Marni3/CPReady/CODING-ESP32/6de3f12e1b0fb9c9b2b78985ee3d019f.jpeg

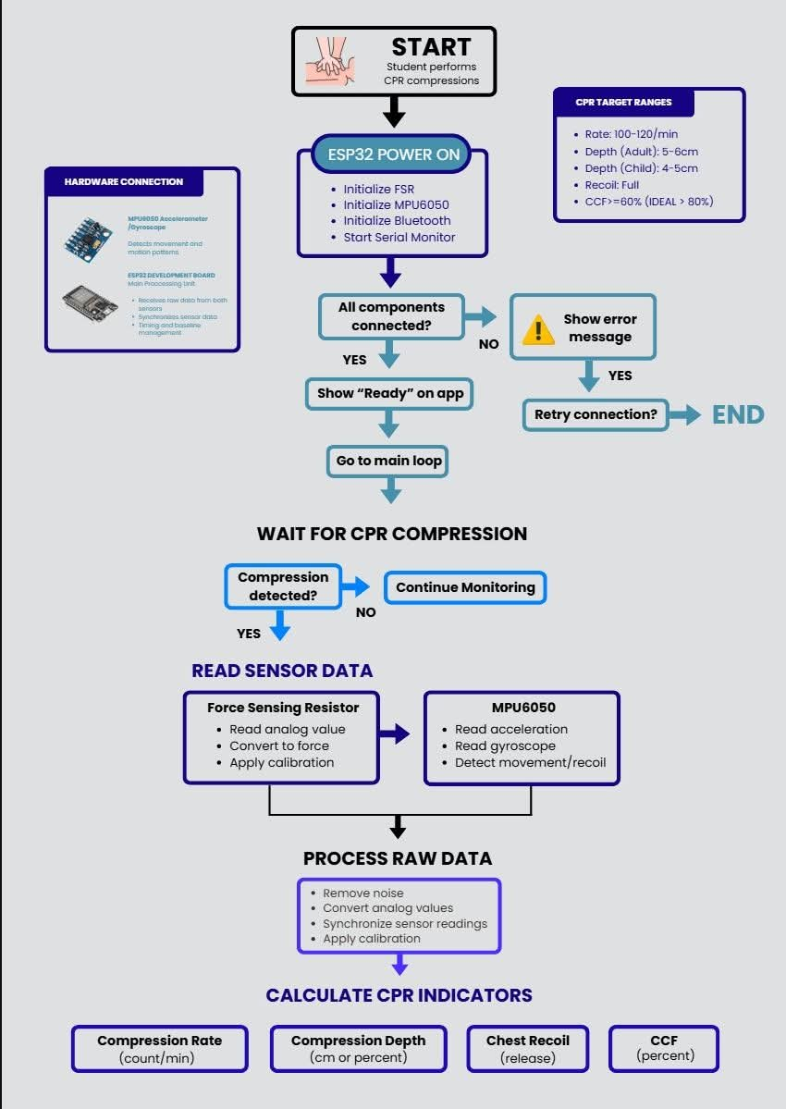
CODING-ESP32/6de3f12e1b0fb9c9b2b78985ee3d019f.jpeg
