Marni3/CPReady/FLUTTER/cpready/README.md

# CPReady Flutter Application

Flutter-based codebase for the **CPReady** CPR Training Vest prototype.

---

Android apk build
``` bash
flutter build apk --release
```
