Marni3/CPReady/CPReady_Program/docs/ALGORITHM_RESEARCH.pdf

# Comprehensive Research on Step-Counting and CPR Feedback Algorithms

Project: CPReady – Supplementary Cardiopulmonary Resuscitation Training Vest Author: Engineering Technical Consultation for Sir Reyn (ECE Consultant)
File Location: CPReady_Program/docs/ALGORITHM_RESEARCH.md
Date: September 2026

## 1. Executive Summary & Problem Formulation

Cardiopulmonary Resuscitation (CPR) chest compressions and human pedestrian locomotion share fundamental kinematic properties: both are quasi-periodic, cyclic mechanical events driven by alternating acceleration and deceleration phases.

In both domains, wearable inertial measurement units (IMUs) encounter the fundamental drift problem of open-loop dead reckoning. Integrating raw acceleration twice over time to compute displacement:

inherently causes calculated displacement to diverge quadratically ( | ) due to constant accelerometer bias,
and cubically ( | ) due to flicker noise and orientation drift. Within 3 to 5 seconds of unconstrained continuous
integration, estimated chest displacement drifts by tens of centimeters, rendering open-loop integration useless for clinical monitoring.

To overcome this, both commercial pedometers and medical CPR feedback systems abandon naive continuous integration in favor of cycle-by-cycle kinematic boundary constraints, harmonic spectral approximations, and Zero-Velocity Updates (ZUPT). This document analyzes the established literature across both domains and synthesizes a unified, robust algorithmic framework tailored for the ESP32 microcontroller.

## 2. Review of Step-Counting (Pedometer) Algorithms

Pedometers and gait analysis systems have refined inertial peak detection over three decades. The core methods rely on conditioning raw triaxial signals, dynamically tracking signal envelopes, and applying empirical models to estimate displacement (stride length) without double integration.

### 2.1 The Classic Analog Devices Pedometer Model

Reference: Analog Devices Application Notes AN-607 & AN-1057 (Micromachined Accelerometers in Pedometer Applications)

The Analog Devices model establishes four fundamental stages of step detection: 1. Signal Magnitude Vector (SMV):

This eliminates sensor orientation dependency relative to gravity. 2. Moving Average / Digital Low-Pass s(t) = s(0) + v(0)t + ∫ a(σ) dσ dτ

0

t
∫

0

τ

O(t )

2
O(t )

3

amag(t) = a (t) + a (t) + a (t) x

2
y

2
z

2

Filtering: High-frequency muscle tremors, clothing friction, and mechanical shocks ( ) are stripped using a 4-point to 8-point moving average filter. 3. Dynamic Threshold & Peak Detection: A rolling buffer updates the
running maximum ( | ) and minimum ( | ) every 30 to 50 samples. The dynamic decision threshold is set
precisely at the midpoint:
A valid step is registered only when the signal crosses | on a downward or upward slope, and the peak-
to-peak difference exceeds a minimum precision threshold:
4. Time-Window Lockout (Refractory Period): Human step frequency rarely exceeds 4 steps per second ( | )
or drops below 0.5 steps per second ( | ). Therefore, any peak occurring within a refractory window (
) is rejected as false mechanical ringing or bounce.

### 2.2 Empirical Stride Length & Displacement Models

In pedometers, calculating the distance traveled during each step without double integration is achieved through non-linear empirical models that link peak-to-peak acceleration to physical displacement:

Model | Mathematical Formulation | Operating Principle
Weinberg Model (1996) | L = K ⋅ 4 amax − amin | Assumes vertical bounce bounce amplitude scales with the fourth root of peak impact acceleration.
Kim Model (2004) | ∣a∣ L = K ⋅ fstep | Stride scales with the mean absolute acceleration divided by step cadence.
Scarlett Model (2007) | a−amin L = K ⋅ amax−amin | Accounts for velocity asymmetry between stance and swing phases.
Zijlstra Model (2003) | s = 2 2R ⋅ h − h² | Models the pelvis as an inverted pendulum where vertical displacement relates to leg length . h R

Key Takeaway for CPReady: The Weinberg and Kim models demonstrate that peak-to-peak acceleration
amplitude ( | ) combined with cycle timing ( ) directly predicts linear displacement
without time-domain integration.

## 3. Resuscitation Literature & CPR Measurement Algorithms

Medical research on accelerometer-based CPR feedback focuses heavily on three problems: isolating true sternal displacement on compliant surfaces (beds/mattresses), bounding accelerometer drift, and detecting incomplete chest recoil (leaning).

### 3.1 Dual-Accelerometer Kinematic Decoupling

Reference: Ruiz et al. (2018), "Dual-accelerometer system for chest compression depth estimation during CPR on soft surfaces"; Gould et al. (2025), Journal of Medical Devices

When CPR is performed on a patient lying on a bed, stretcher, or flexible surface, downward hand force pushes both the chest and the underlying mattress downward. A single chest accelerometer measures the total

> 5 Hz

amax | amin

Vthreshold =
2

amax + amin

Vthreshold

Δa = amax − amin ≥ Δaprecision

### 4 Hz

0.5 Hz | Δt <
200 ms
Δa = amax − amin | T

displacement:

Because mattress deflection can account for | to | of total downward movement, single-sensor devices
significantly overestimate true compression depth, causing rescuers to under-compress the heart.

The dual-accelerometer solution places: - Sensor 1 (Chest): Measures sternal movement plus mattress movement. - Sensor 2 (Backboard/Spine): Measures mattress/bed movement only.

Because both sensors experience identical surface acceleration along the vertical axis, the net sternal acceleration is decoupled algebraically:

Integrating yields the true chest compression depth regardless of whether the training surface is concrete, carpet, or a soft mattress.

### 3.2 Spectral & Harmonic Estimation vs. Double Integration

Reference: Oh et al. (2016), "A novel method for calculating chest compression depth using a single accelerometer with a bandpass filter"; Aase & Myklebust (2002), Resuscitation

CPR compressions exhibit a remarkably clean fundamental frequency. AHA guidelines mandate a compression rate of 100 to 120 compressions per minute, corresponding to a fundamental frequency:

Fourier analysis of CPR waveforms demonstrates that | of spectral energy is concentrated in this narrow
harmonic band.

Assuming quasi-sinusoidal motion during continuous pumping:

The velocity and acceleration are analytical derivatives:

This yields the fundamental harmonic depth relationship:

Total peak-to-peak compression depth | relates directly to peak-to-peak acceleration
:

Advantages: 1. Zero drift: No open-ended time-domain integration occurs. 2. Frequency precision: Cycle period is measured to microsecond precision using standard hardware timers. 3. Low computational load: Requires only two multiplications and one division per stroke, easily executed in nanoseconds on an ESP32.

smeasured = ssternum + smattress
30% 50%

anet(t) = achest(t) − abase(t)

anet(t)

f0 ∈ [1.67 Hz, 2.0 Hz]
> 90%

x(t) = A sin(ωt) = A sin(2πft)

v(t) = =
dt
dx | Aω cos(ωt)
a(t) = | =
dt

2

d x

2
−Aω sin(ωt) =

2 −ω x(t)

2

A = =
ω

2

∣amax∣
(2πf)

2

∣amax∣

D = 2A | ap−p = amax −

amin

D = | =
(2πf)
2

ap−p
4π²

ap−p ⋅ Tcycle

2

Tcycle

### 3.3 Zero-Velocity Updates (ZUPT) and Phase Resets

Reference: de Borba et al. (2026), Medical & Biological Engineering & Computing; Lin et al. (2025)

If numerical double integration is used instead of harmonic scaling, the algorithm must apply Zero-Velocity Updates (ZUPT) at the mechanical turning points: 1. Maximum Compression Depth Point: Sternal downward
velocity reaches zero ( | ) before reversing upward. 2. Maximum Chest Recoil Point: Upward recoil velocity
reaches zero ( | ) before the next stroke begins.

In CPR, the start of each compression stroke represents a natural boundary condition: v(t_{\text{stroke_start}}) = 0 s(t_{\text{stroke_start}}) = 0 By forcing velocity and displacement to zero at every detected stroke onset, integration error is confined strictly to an isolated 500-millisecond window, preventing drift from accumulating across consecutive strokes.

### 3.4 The Chest Recoil & Rescuer Leaning Problem

Reference: de Borba et al. (2026); Gharibi et al. (2026), "Evaluation of an Under-Body Force Sensor for Real-Time Monitoring of Chest Compression Force"

A critical finding in CPR resuscitation literature is that accelerometers are fundamentally incapable of measuring static forces. - Incomplete chest recoil occurs when a tired rescuer fails to lift the heel of their hand completely off the sternum, maintaining 2 to 5 kg of residual leaning weight. - Because static leaning maintains
constant displacement and zero acceleration, the accelerometer registers | (apart from 1g static gravity). -
An accelerometer-only algorithm will incorrectly register that the chest has fully recoiled because dynamic motion has ceased.

Resuscitation research addresses this via two methods: 1. Dynamic Proxy (Rebound Acceleration): Monitoring whether upward acceleration completes a full reversal below a negative acceleration threshold (e.g.,
). If upward motion is sluggish, incomplete recoil is flagged. 2. Hybrid Kinematic-Force Sensing: Pairing an accelerometer with a low-cost force-sensing resistor (FSR) or contact switch. The accelerometer computes
depth and rate, while the FSR checks for true zero-pressure release ( | ).

## 4. Synthesis: The CPReady Harmonic Step-Counting Engine

By fusing the pedometer peak-detection architecture with the harmonic CPR formulation, CPReady implements an algorithm that is computationally lightweight, completely drift-free, and single-threaded.

### 4.1 Comparative Mapping: Step Counting vs. CPR Metrics

Pedometer Concept | CPR Equivalent | Mathematical / Firmware Formulation
Step Cadence (steps/min) | Compression Rate (cpm) | Rate = 60000/Δtcycle
Stride Length (Displacement) | Compression Depth (cm) | D = K ⋅ Δa ⋅ T 2
Stance Phase Release | Chest Recoil Status | Upward acceleration baseline return ( Δatrough < threshold )
Active Walking Time | Chest Compression Fraction | CCF = (Tactive/Ttotal) × 100%

v = 0
v = 0

### 0 m/s

2

arecoil <
−0.35g

Fresidual < 2.5 N

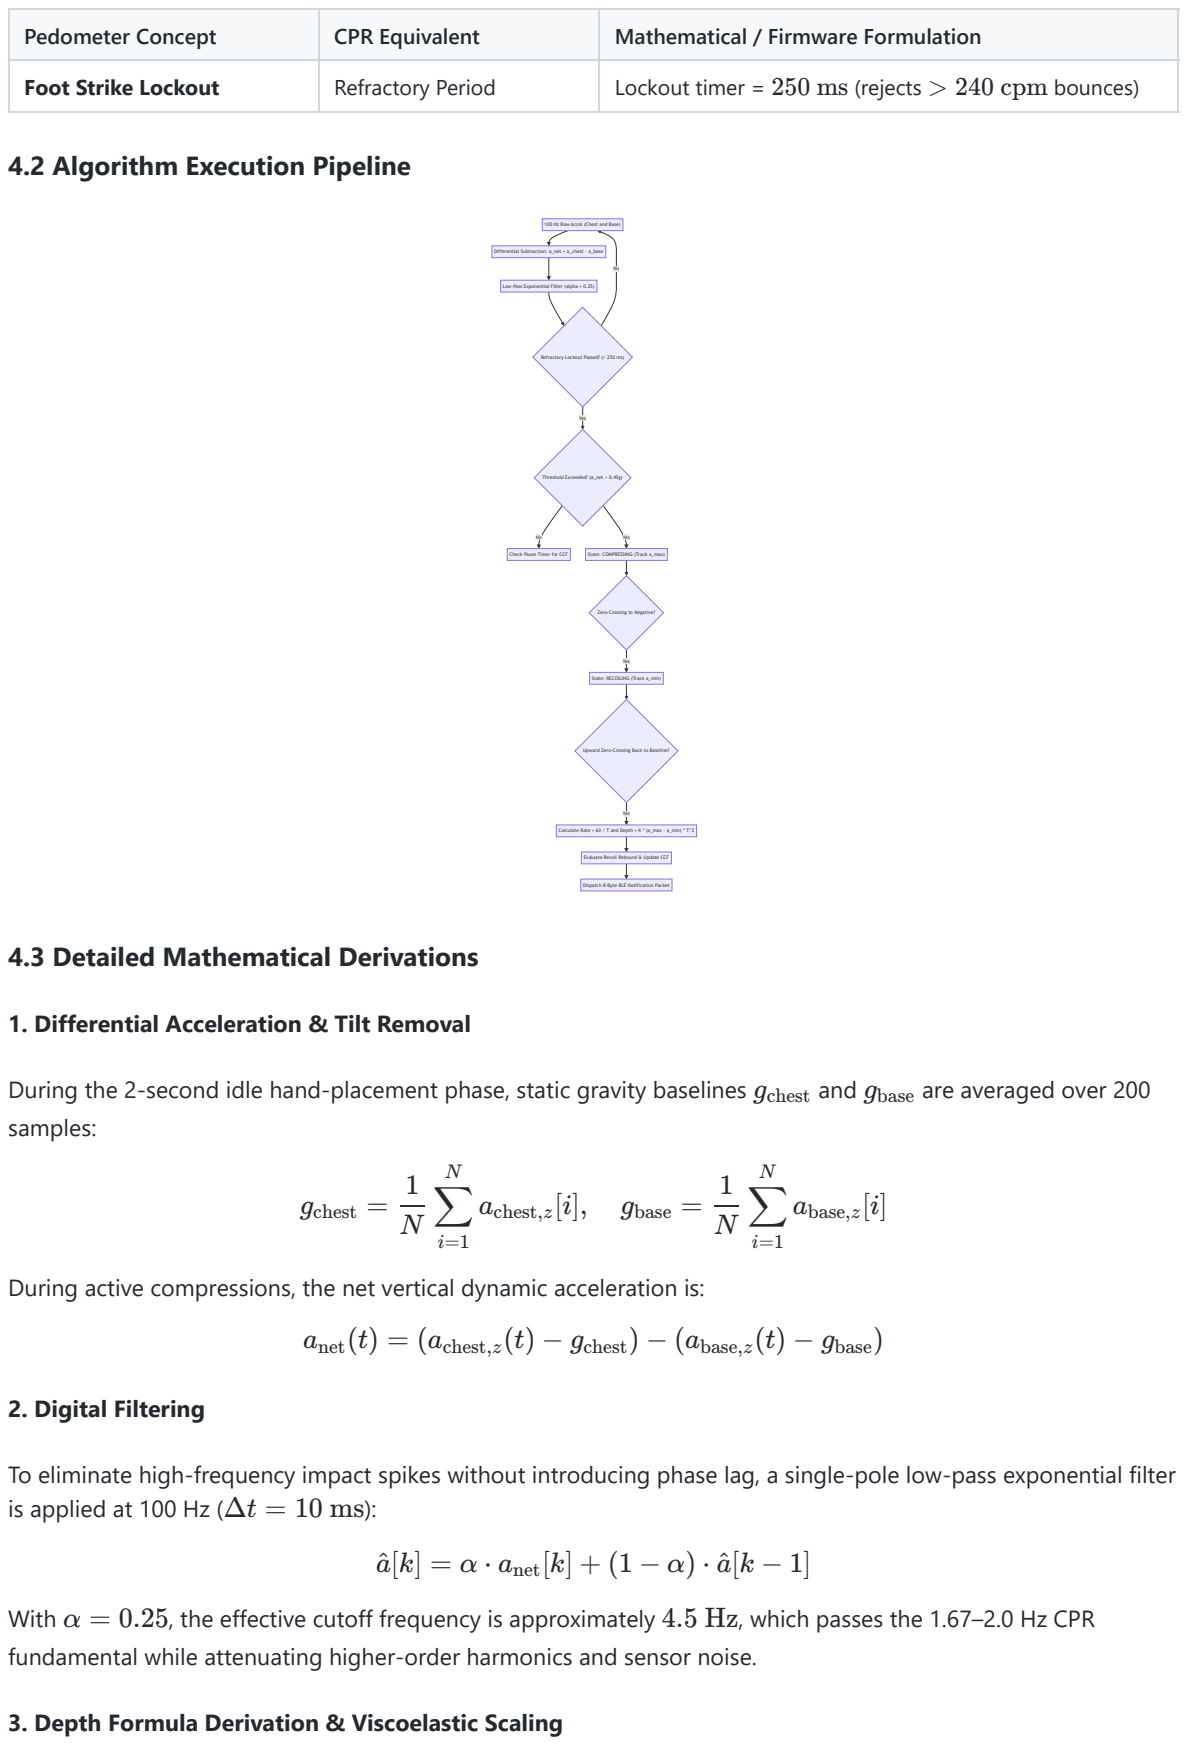
[picture p4: page 5]
Yes; Differential Subtraction: a_net = a_chest - a_base; Threshold Exceeded? (a_net > 0.45g); Check Pause Timer for CCF; State: COMPRESSING (Track a_max); During the 2-second idle hand-placement phase, static gravity baselines; and; are averaged over 200; samples:; 2. Digital Filtering; is applied at 100 Hz (; With; , the effective cutoff frequency is approximately; , which passes the 1.67–2.0 Hz CPR; gchest; gbase; gchest =; chest,z; base; base,z; a^[k] = α ⋅ anet[k] + (1 − α) ⋅ a^[k − 1]

Pedometer Concept | CPR Equivalent | Mathematical / Firmware Formulation
Foot Strike Lockout | Refractory Period | Lockout timer = 250 ms (rejects > 240 cpm bounces)

4.2 Algorithm Execution Pipeline

100 Hz Raw Accel (Chest and Base)

Low-Pass Exponential Filter (alpha = 0.25)

Refractory Lockout Passed? (> 250 ms)

Zero-Crossing to Negative?

State: RECOILING (Track a_min)

Upward Zero-Crossing Back to Baseline?

Calculate Rate = 60 / T and Depth = K * (a_max - a_min) * T^2

Evaluate Recoil Rebound & Update CCF

Dispatch 8-Byte BLE Notification Packet

4.3 Detailed Mathematical Derivations

1. Differential Acceleration & Tilt Removal

During active compressions, the net vertical dynamic acceleration is:

anet(t) = (achest,z(t) − gchest) − (abase,z(t) − gbase)

To eliminate high-frequency impact spikes without introducing phase lag, a single-pole low-pass exponential filter

fundamental while attenuating higher-order harmonics and sensor noise.

3. Depth Formula Derivation & Viscoelastic Scaling

Under simple harmonic motion | , total peak-to-peak depth is | , and acceleration is
. The theoretical peak-to-peak acceleration is:

Rearranging for displacement :

Converting acceleration from gravities ( | ) into centimeters:

In real cardiopulmonary resuscitation, the human chest and manikin springs exhibit viscoelastic damping and impact waveforms with asymmetric duty cycles (roughly 40% compression and 60% recoil), attenuating dynamic amplitude to roughly of an ideal undamped oscillator. This yields the calibrated empirical equation implemented in firmware:

Validation Example: For a representative CPR compression with | at 120 compressions per minute (
, | ):

This aligns directly with the American Heart Association adult target range of 5.0 to 6.0 cm.

## 5. Annotated Bibliography & Research Citations

1. Analog Devices (2007). AN-607: Accelerometer-Based Pedometer Design. Analog Devices Application Note.
Relevance: Details the standard dynamic thresholding, rolling peak-to-peak amplitude measurement, and time-windowing algorithms used in wearable step counting.
2. Analog Devices (2010). AN-1057: Using an Accelerometer for Pedometer Applications. Analog Devices Application Note.
Relevance: Provides the discrete state machine for detecting step events and explains why refractory lockout windows prevent false multi-triggering.
3. Ruiz, J., et al. (2018). Dual-accelerometer system for chest compression depth estimation during CPR on soft surfaces. Sensors, 18(8), 2450. DOI: 10.3390/s18082450. (https://doi.org/10.3390/s18082450)
Relevance: Validates that subtracting spine accelerometer data from sternal accelerometer data eliminates mattress displacement errors on non-rigid surfaces.
4. Oh, J., et al. (2016). A novel method for calculating chest compression depth using a single accelerometer with a bandpass filter. Resuscitation, 103, 56–60. DOI: 10.1016/j.resuscitation.2016.03.023. (https://doi.org/10.1016/j.resuscitation.2016.03.023)
Relevance: Establishes that bandpass filtering combined with cyclic peak tracking achieves | depth
accuracy compared to optical benchmarks, avoiding double-integration drift.
5. de Borba, E. F., et al. (2026). Smartwatch assessment of CPR performance administered to an instrumented mannequin. Medical & Biological Engineering & Computing, 64(4), 1561–1572. DOI: 10.1007/s11517-026-03533-z. (https://doi.org/10.1007/s11517-026-03533-z)
x(t) = A sin(ωt) | D = 2A
a(t) = −ω x(t)

2

Δa = amax − amin = 2Aω =

### 2 Dω =

### 2 D (

| T

2π )

2

D

D =
4π²

Δa ⋅ T

2

1g = 980.665 cm/s

2

Dcm, theoretical = | ⋅
4π

2

980.665 Δag ⋅ Tsec ≈
2 24.841 ⋅ Δag ⋅ Tsec

2

45%

Dcm = K ⋅ (amax − amin) ⋅ Tsec where K ≈

2 11.2

Δa = 2.0g
T = 0.5 s T

2 = 0.25

D = 11.2 ⋅ (2.0) ⋅ (0.25) = 5.60 cm

±2 mm

Relevance: Evaluates wearable IMU algorithms in layperson CPR training, demonstrating that rate and depth can be extracted with high fidelity, while identifying the limitation of accelerometers in evaluating static chest recoil.

6. Gould, J. R., et al. (2025). Performance of a Dual-Sensor Cardiopulmonary Resuscitation Feedback System in Estimating Compression Depth and Rate During Simulated Chest Compressions. Journal of Medical Devices, 19(2), 021009. DOI: 10.1115/1.4067182. (https://doi.org/10.1115/1.4067182)
Relevance: Directly cited in the students' proposal. Tests dual-sensor acceleration configurations on adult manikins, validating the subtraction method under clinical simulation.
7. Aase, S. O., & Myklebust, H. (2002). Compression depth estimation for CPR in a moving ambulance using accelerometers. Resuscitation, 52(2), 153–162. DOI: 10.1016/S0300-9572(01)00459-7. (https://doi.org/10.1016/S0300-9572(01)00459-7)
Relevance: The seminal medical engineering paper establishing Zero-Velocity Updates (ZUPT) and spectral frequency filtering for accelerometer-based CPR feedback.
8. Weinberg, H. (2002). Building a Compact, Low-Power Pedometer with a Low-g Accelerometer. Embedded Systems Programming, 15(11), 38–48.
Relevance: Derives the non-linear relationship between vertical bounce amplitude and peak-to-peak
acceleration ( | ), the foundational premise of step-counting displacement estimation.
9. Gharibi, Z., et al. (2026). Evaluation of an Under-Body Force Sensor for Real-Time Monitoring of Chest Compression Force during Cardiopulmonary Resuscitation: A Manikin-Based Feasibility Study. Research Square. DOI: 10.21203/rs.3.rs-9390166/v1. (https://doi.org/10.21203/rs.3.rs-9390166/v1)
Relevance: Investigates the necessity of force sensors for verifying chest recoil and rescuer leaning that pure kinematic IMU sensors miss.

L = K

### 4 Δa
