Marni3/CPReady/CODING-ESP32/0459f18023e26a456a915082fbb5177e.jpeg

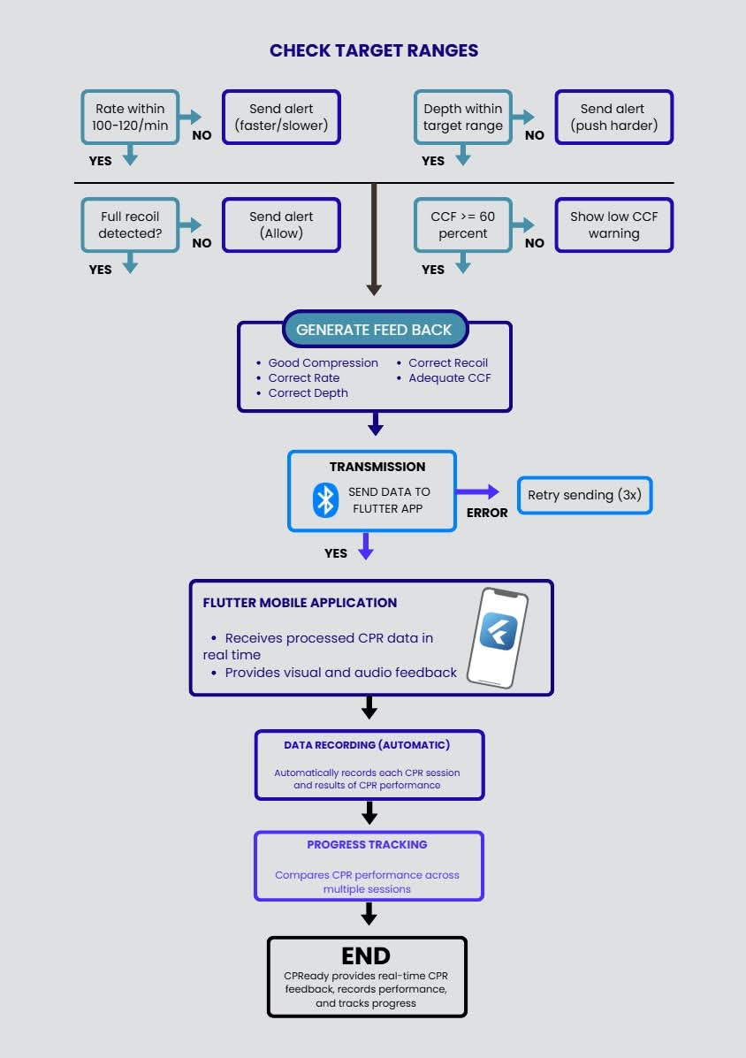
CODING-ESP32/0459f18023e26a456a915082fbb5177e.jpeg
