Marni3/CPReady/DATA/Double MPU/2MPU_Strict2.jpg

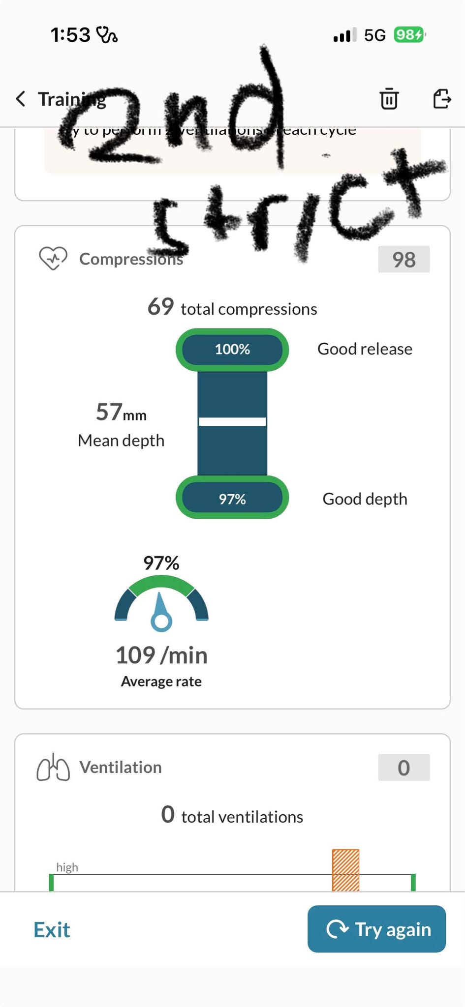
DATA/Double MPU/2MPU_Strict2.jpg
