Marni3/CPReady/DATA/organized_trials/01_2MPU_Balanced1_a4dc7413/2MPU_Balanced1.jpg

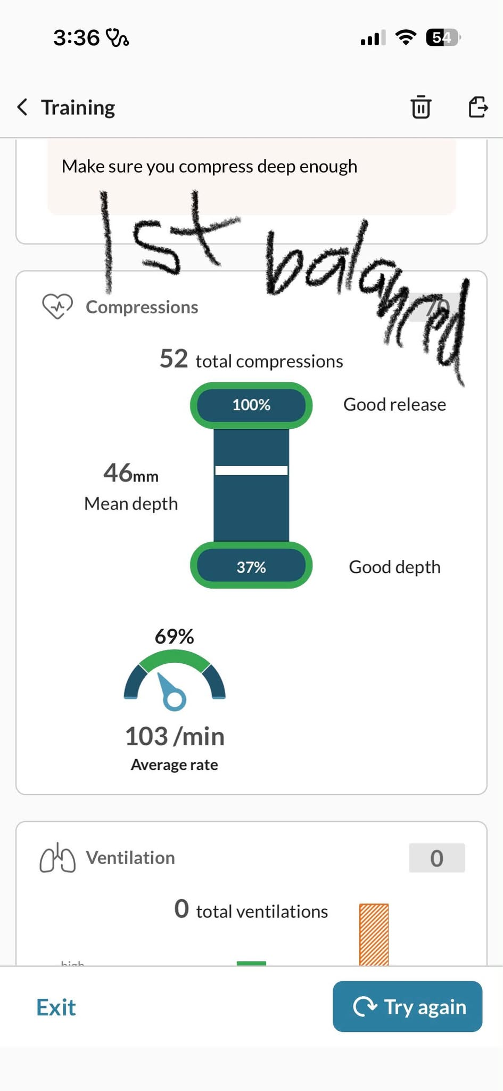
DATA/organized_trials/01_2MPU_Balanced1_a4dc7413/2MPU_Balanced1.jpg
