Marni3/CPReady/DATA/organized_trials/02_2MPU_Balanced2_e5e68774/2MPU_Balanced2.jpg

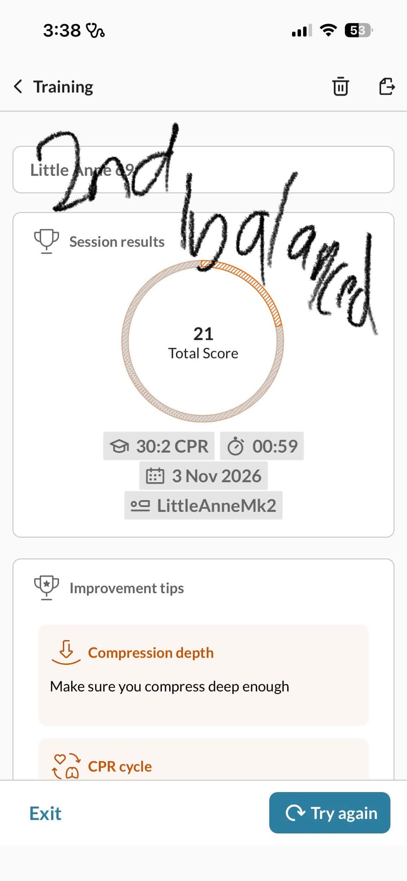
DATA/organized_trials/02_2MPU_Balanced2_e5e68774/2MPU_Balanced2.jpg
