Marni3/CPReady/DATA/organized_trials/04_2MPU_Strict1_7c5ea2c3/2MPU_Strict1.jpg

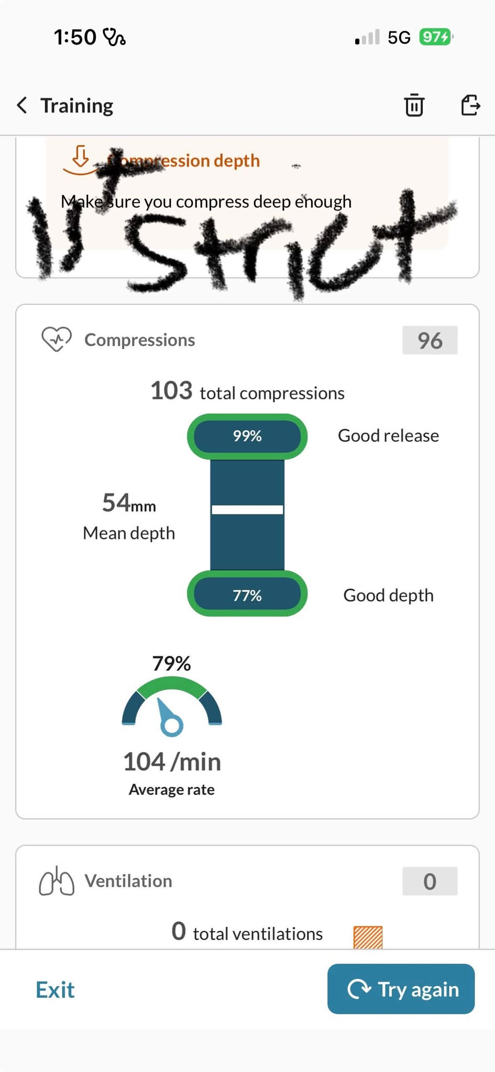
DATA/organized_trials/04_2MPU_Strict1_7c5ea2c3/2MPU_Strict1.jpg
