Marni3/CPReady/DATA/organized_trials/06_2MPU_High1_343540cf/2MPU_High1.jpg

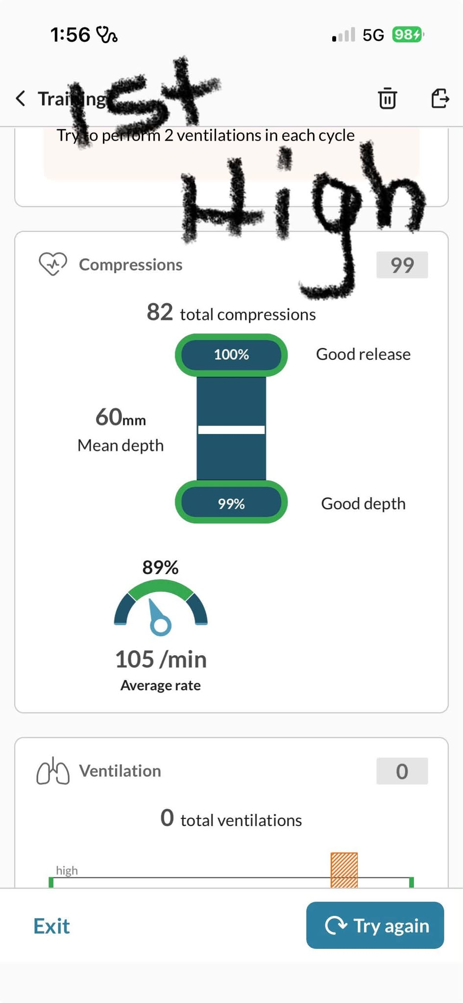
DATA/organized_trials/06_2MPU_High1_343540cf/2MPU_High1.jpg
