Marni3/CPReady/DATA/organized_trials/07_2MPU_High2_e5c4ad3a/2MPU_High2.jpg

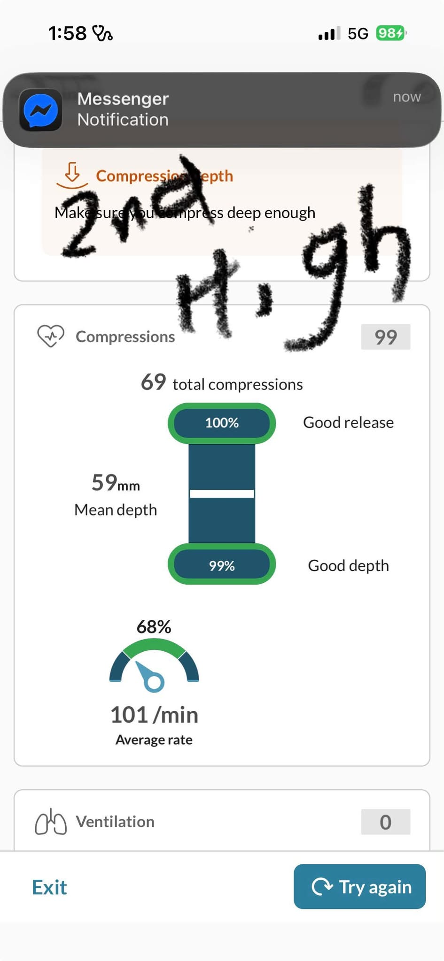
DATA/organized_trials/07_2MPU_High2_e5c4ad3a/2MPU_High2.jpg
