Marni3/CPReady/DATA/organized_trials/08_1MPU_Strict1_6ee8938f/1MPU_Strict1.jpg

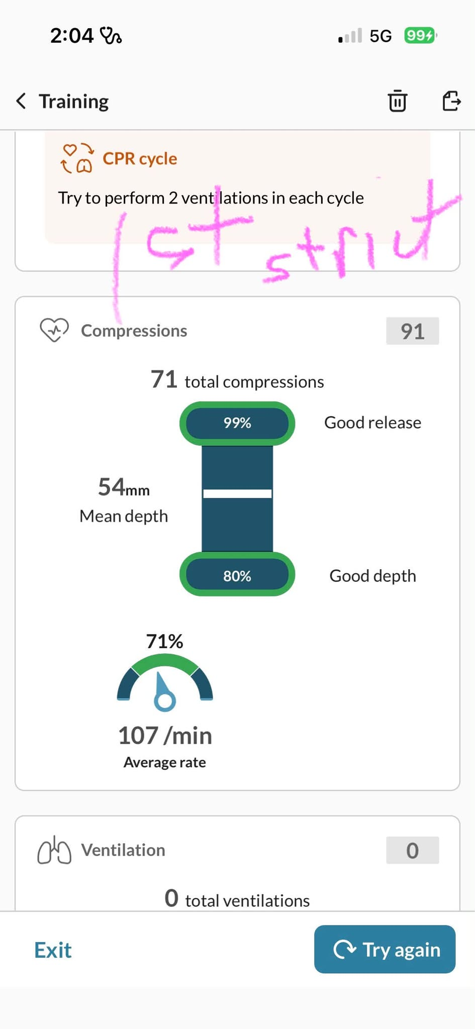
DATA/organized_trials/08_1MPU_Strict1_6ee8938f/1MPU_Strict1.jpg
