Marni3/CPReady/DATA/organized_trials/10_1MPU_Balanced1_48011a51/1MPU_Balanced1.jpg

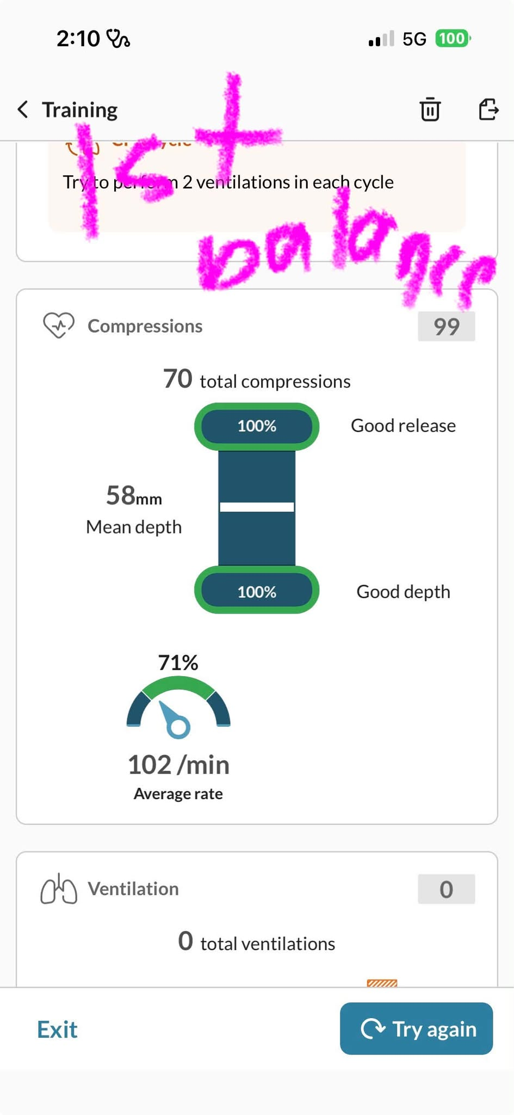
DATA/organized_trials/10_1MPU_Balanced1_48011a51/1MPU_Balanced1.jpg
