Marni3/CPReady/DATA/Single MPU/1MPU_Balanced2.jpg

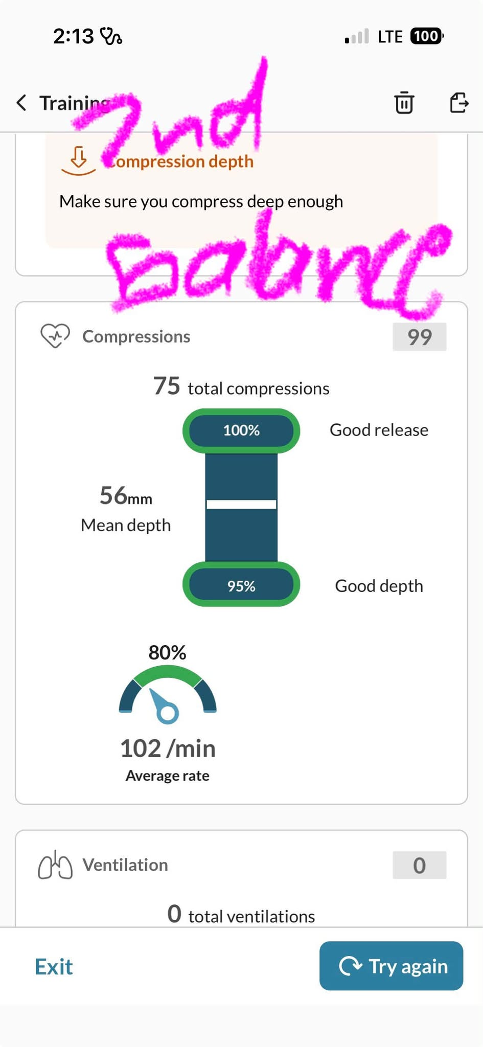
DATA/Single MPU/1MPU_Balanced2.jpg
