Marni3/CPReady/DATA/Single MPU/1MPU_High1.jpg

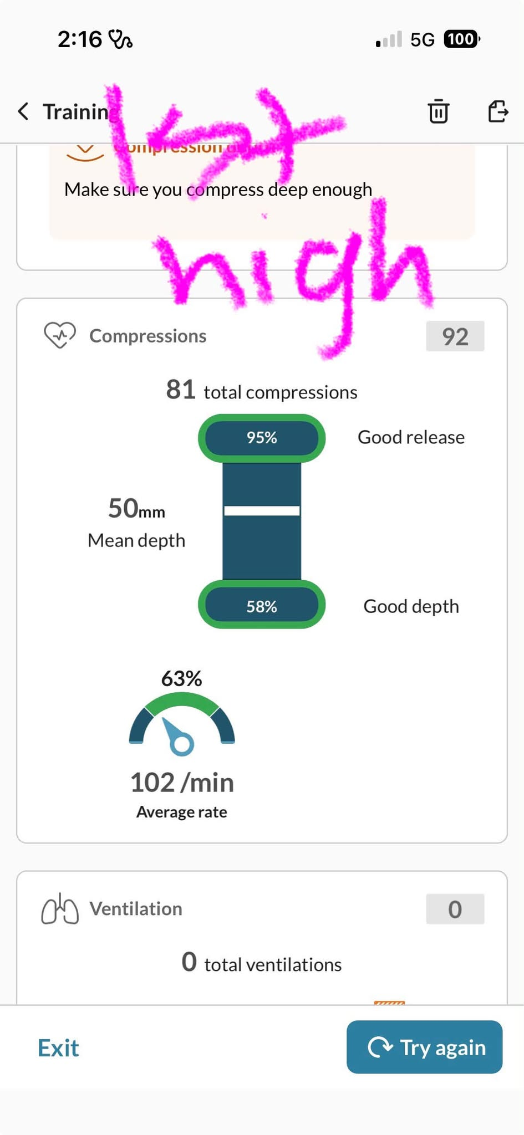
DATA/Single MPU/1MPU_High1.jpg
