Marni3/CPReady/DATA/Single MPU/1MPU_High2.jpg

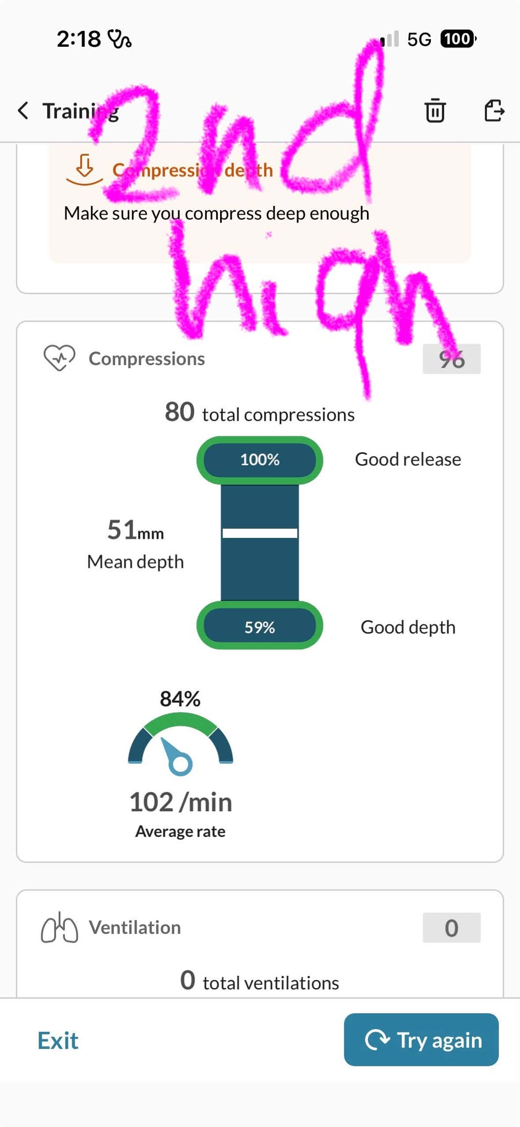
DATA/Single MPU/1MPU_High2.jpg
