Marni3/CPReady/DATA/Single MPU/1MPU_Strict2.jpg

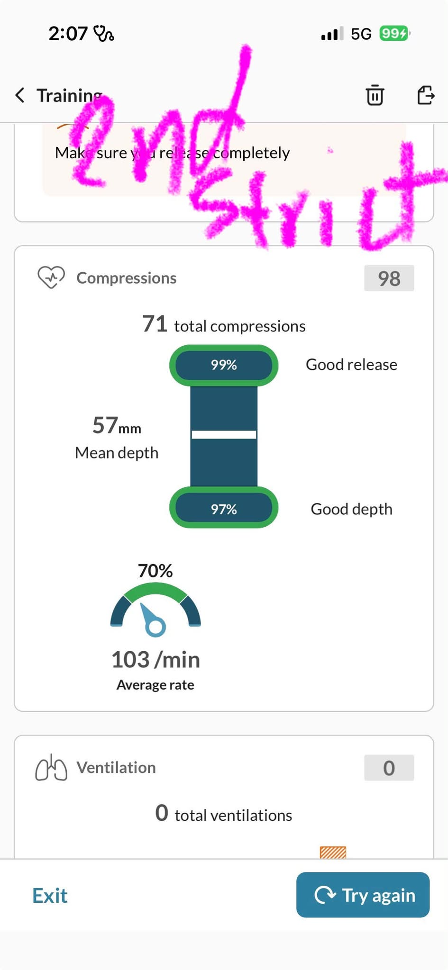
DATA/Single MPU/1MPU_Strict2.jpg
