Marni3/CPReady/FLUTTER/app_assets/images/bluetooth_unconnected.png

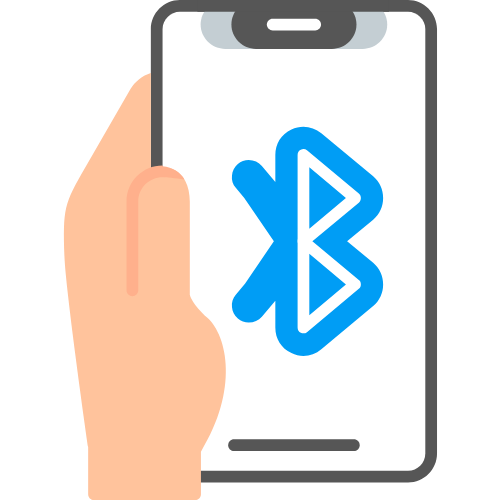
FLUTTER/app_assets/images/bluetooth_unconnected.png
