Marni3/CPReady/FLUTTER/cpready/assets/images/heartbeat.png

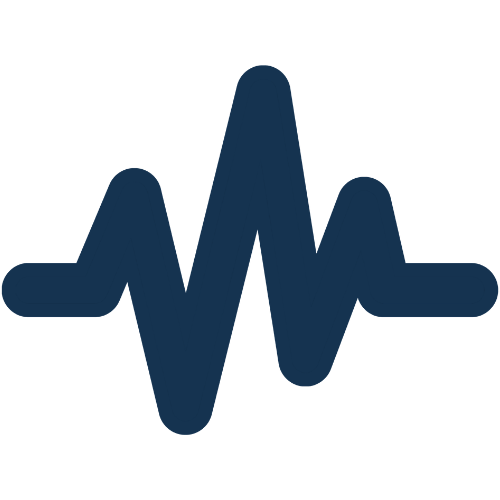
FLUTTER/cpready/assets/images/heartbeat.png
