Marni3/CPReady/FLUTTER/cpready/assets/images/home.png

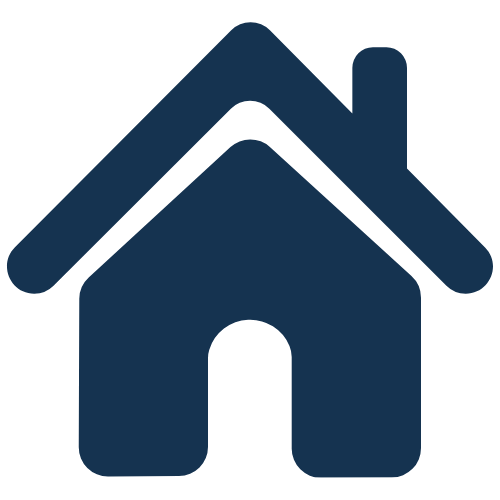
FLUTTER/cpready/assets/images/home.png
