Marni3/CPReady/FLUTTER/cpready/assets/images/metronome.png

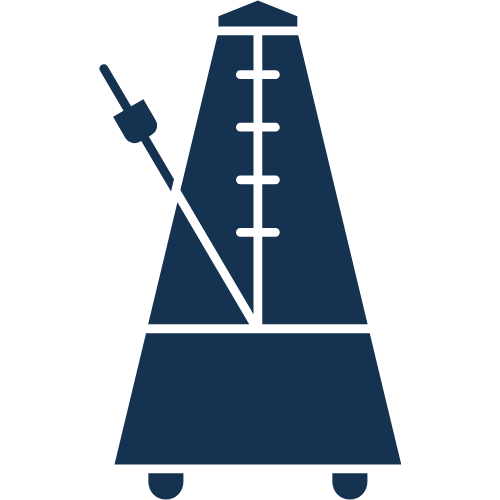
FLUTTER/cpready/assets/images/metronome.png
