Marni3/CPReady/FLUTTER/cpready/flutter_02.png

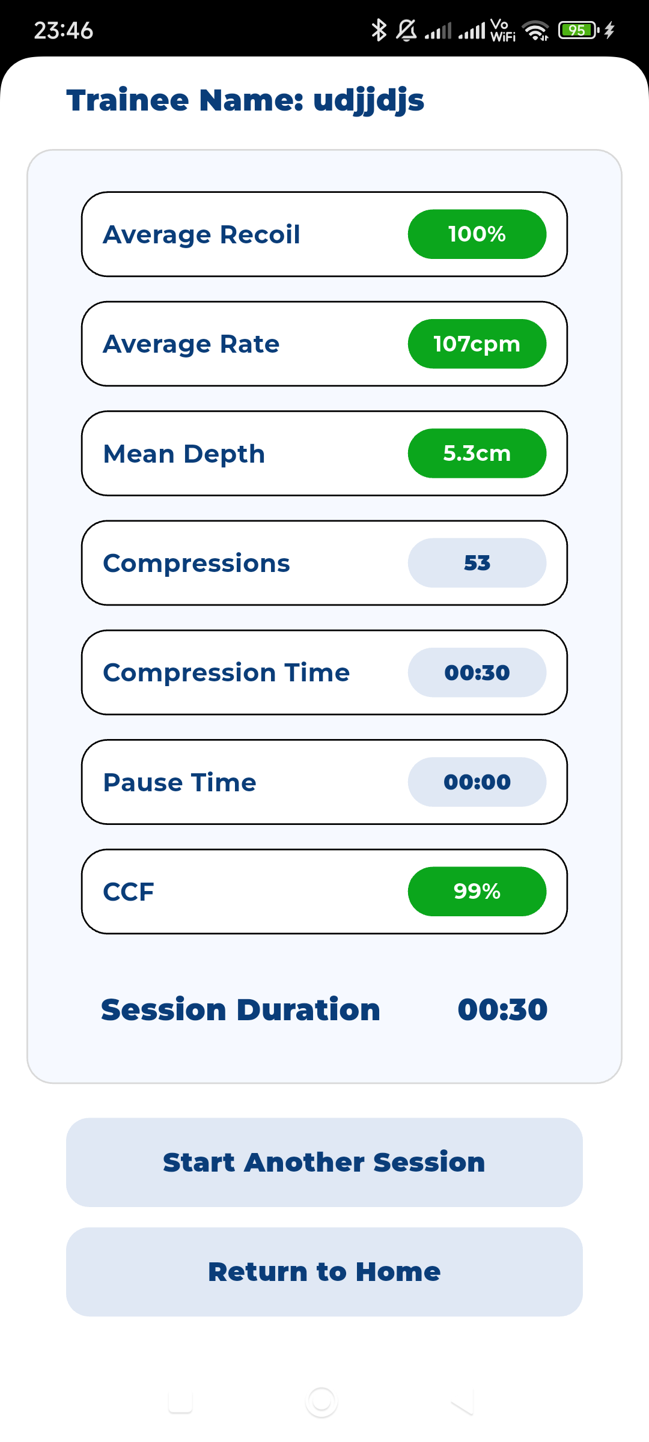
FLUTTER/cpready/flutter_02.png
