Marni3/CPReady/(list of files, cad)

Other CAD files:
Schematic and PCB/CPReady_Electronics/usini_kicad_sensors-main/sources/fusion360/MPL3115A2.f3d
Schematic and PCB/CPReady_Electronics/usini_kicad_sensors-main/sources/fusion360/PAJ7620.f3d
Schematic and PCB/CPReady_Electronics/usini_kicad_sensors-main/sources/fusion360/adxl345.f3d
Schematic and PCB/CPReady_Electronics/usini_kicad_sensors-main/sources/fusion360/audio_3.5mm_trrs.f3d
Schematic and PCB/CPReady_Electronics/usini_kicad_sensors-main/sources/fusion360/bmp180.f3d
Schematic and PCB/CPReady_Electronics/usini_kicad_sensors-main/sources/fusion360/module_si7021.f3d
Schematic and PCB/CPReady_Electronics/usini_kicad_sensors-main/sources/fusion360/tsl2561.f3d
