Marni3/CPReady/CPReady_Test_Bench/mock_portal.html

# CPReady Bench

Clinical CPR Metric Validation Voice Enabled

Chest: OK (0x68) Spine: Offline

Voice Coach Active

Phone Speaker

### Single MPU (Chest Only)

Measuring sternal compression with baseline zeroing.

Switch Mode

Calibrate (2s) Start Test

Rest hands on chest & calibrate Reset Stats

Rate

-- cpm

AHA: 100–120 cpm

Depth

-- cm

AHA: 5.0–6.0 cm (--mm)

Recoil

READY

Compliance: 100%

CCF Active

-- %

AHA Target: ≥ 60%

Compressions

0 strokes

Elapsed: 0s

Net Accel

0.00 g

Trigger: 0.45 g

### Web Speech Voice Coach (Phone Speaker)

🔊 Voice: ON

Tap any button below to test how your browser immediately speaks the clinical coaching prompts out loud using its native voice engine:

🗣️ "Push harder" 🗣️ "Push shallower" 🗣️ "Release completely" 🗣️ "Speed up" 🗣️ "Slow down" 🗣️ "Good compressions"

Simulate Rescuer CPR Scenario during Test:

Status: Idle (Start Test to begin) Cooldown: 0s

Voice Engine:

Parameter Calibration Reset

Depth Multiplier (K) 11.2

Scales measured bounce into centimeters. If your physical ruler measures 5.0 cm but the screen shows 4.0 cm, increase this number.

Push Sensitivity 0.45 g

Minimum force to trigger a downstroke. Lower this if soft compressions aren't counting; raise it if bumps trigger false strokes.

Recoil Strictness -0.35 g

Upward snap-back check. If trainees release fully but it warns 'Leaning', move this slider closer to zero (e.g. -0.25 g).

Refractory Lockout 250 ms

Rest window between strokes to stop foam bounce from double-counting. 250 ms safely caps rate to 240 cpm.

💾 Save Settings to Memory (Safe Flash) 📋 Generate C++ Config for Paper
