Marni3/CPReady/audit_evidence/tracker_replay/results_harmonic_estimator.txt

shape            cpm  trueD  lean |     estD   estCpm
sine              80    4.0   0.0 |     4.00     79.9
sine              80    5.5   1.5 |     5.51     79.9
sine              80    7.0   0.0 |     7.01     79.9
sine             100    4.0   0.0 |     4.00     99.9
sine             100    5.5   1.5 |     5.50     99.9
sine             100    7.0   0.0 |     7.00     99.9
sine             120    4.0   0.0 |     4.02    119.9
sine             120    5.5   1.5 |     5.52    119.9
sine             120    7.0   0.0 |     7.02    119.9
sine             150    4.0   0.0 |     4.01    149.9
sine             150    5.5   1.5 |     5.51    149.9
sine             150    7.0   0.0 |     7.01    149.9
40/60 duty        80    4.0   0.0 |     3.95     80.3
40/60 duty        80    5.5   1.5 |     5.43     80.3
40/60 duty        80    7.0   0.0 |     6.92     80.3
40/60 duty       100    4.0   0.0 |     3.94    100.3
40/60 duty       100    5.5   1.5 |     5.43    100.3
40/60 duty       100    7.0   0.0 |     6.91    100.3
40/60 duty       120    4.0   0.0 |     3.96    120.3
40/60 duty       120    5.5   1.5 |     5.45    120.3
40/60 duty       120    7.0   0.0 |     6.93    120.3
40/60 duty       150    4.0   0.0 |     3.99    150.1
40/60 duty       150    5.5   1.5 |     5.49    150.1
40/60 duty       150    7.0   0.0 |     6.99    150.1
35/35/30 dwell    80    4.0   0.0 |     3.95     80.1
35/35/30 dwell    80    5.5   1.5 |     5.43     80.1
35/35/30 dwell    80    7.0   0.0 |     6.91     80.1
35/35/30 dwell   100    4.0   0.0 |     4.07    100.1
35/35/30 dwell   100    5.5   1.5 |     5.60    100.1
35/35/30 dwell   100    7.0   0.0 |     7.13    100.1
35/35/30 dwell   120    4.0   0.0 |     4.01    120.1
35/35/30 dwell   120    5.5   1.5 |     5.51    120.1
35/35/30 dwell   120    7.0   0.0 |     7.01    120.1
35/35/30 dwell   150    4.0   0.0 |     4.12    150.0
35/35/30 dwell   150    5.5   1.5 |     5.67    150.0
35/35/30 dwell   150    7.0   0.0 |     7.22    150.0
