Marni3/CPReady/APPLICATION/AppFlowChart_Ver2.pdf

## PRACTICE TAB

DEVICE CONNECTION | HISTORY TAB

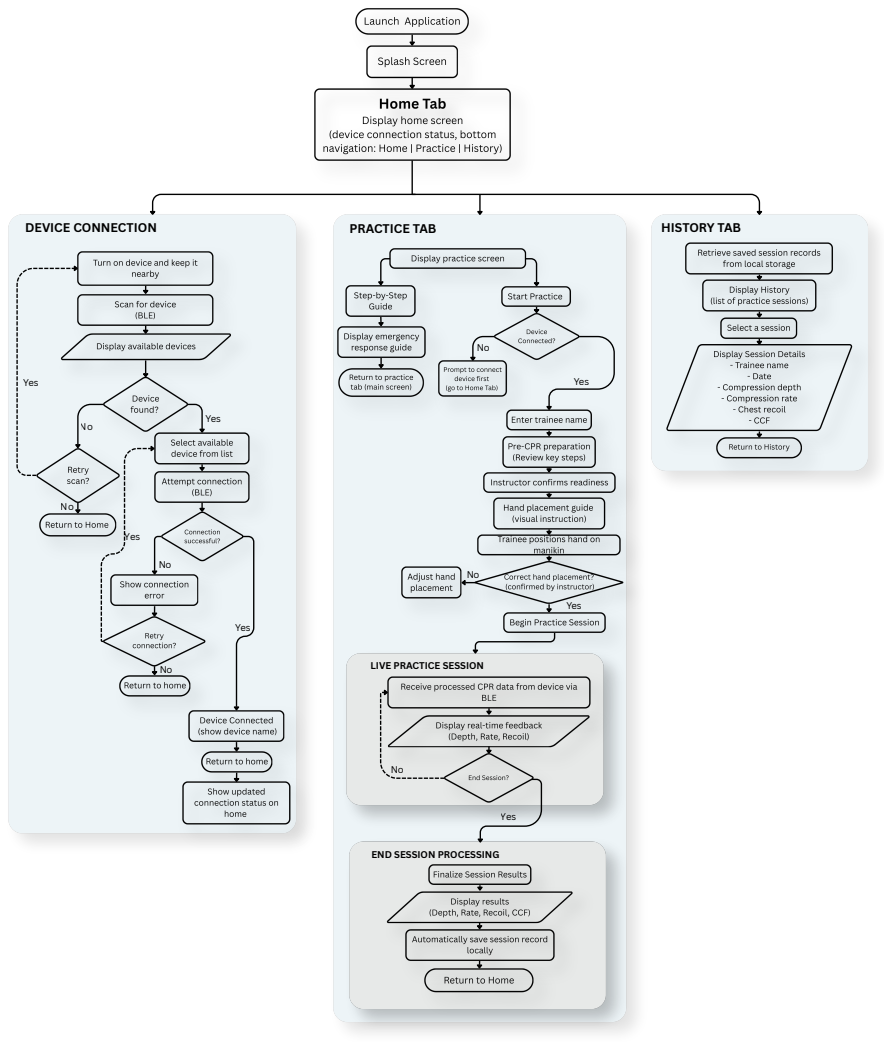
[picture p32: page 1]
Yes

LIVE PRACTICE SESSION

END SESSION PROCESSING
