Marni3/CPReady/Schematic and PCB/CPReady_Electronics/CPReady_Electronics.kicad_sch

## KiCad design Schematic and PCB/CPReady_Electronics/CPReady_Electronics.kicad_sch (2026-10-01)

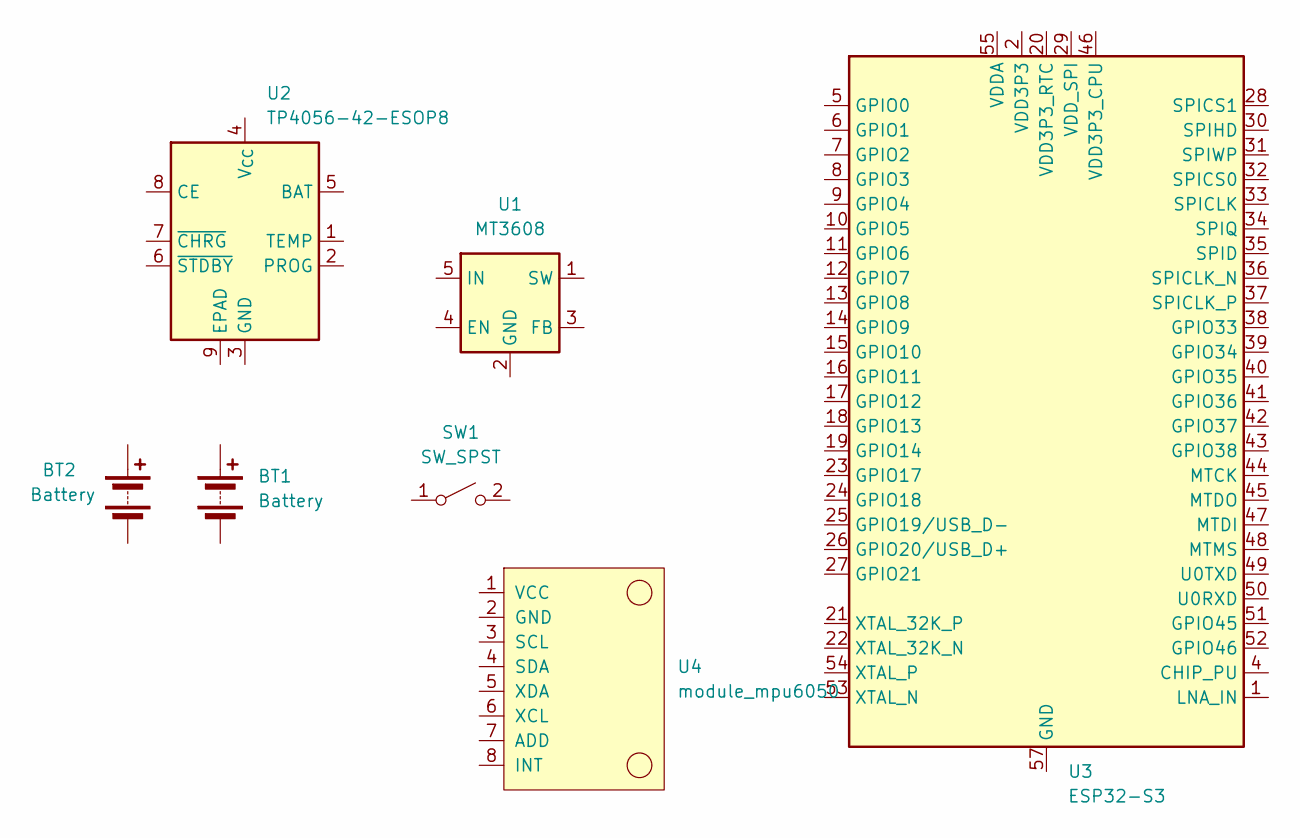
[picture p33: schematic CPReady_Electronics.kicad_sch]

Parts:
BT1, BT2: Battery
SW1: SW_SPST
U1: MT3608; SOT-23-6
U2: TP4056-42-ESOP8; SOIC-8-1EP_3.9x4.9mm_P1.27mm_EP2.41x3.3mm_ThermalVias
U3: ESP32-S3; QFN-56-1EP_7x7mm_P0.4mm_EP4x4mm
U4: module_mpu6050

Connections:
unnamed: U3.2 (VDD3P3), U3.3 (VDD3P3)
unnamed: U3.55 (VDDA), U3.56 (VDDA)
