Marni3/CPReady/CPReady_Program/include/SensorManager.h

#ifndef SENSOR_MANAGER_H
#define SENSOR_MANAGER_H

#include <Wire.h>
#include <Adafruit_MPU6050.h>
#include <Adafruit_Sensor.h>
#ifdef FAKE_SENSORS
#include <math.h>
#endif
#include "CPRTypes.h"
#include "CPReadyConfig.h"
#include "GravityAxis.h"
#include "TelemetryFrames.h"

class SensorManager {
private:
    Adafruit_MPU6050 chestSensor;
    #if USE_DUAL_MPU
    Adafruit_MPU6050 baseSensor;
    #endif
    uint8_t chestMuxChannel;
    #if USE_DUAL_MPU
    uint8_t baseMuxChannel;
    #endif
    uint8_t chestI2CAddr;
    #if USE_DUAL_MPU
    uint8_t baseI2CAddr;
    #endif
    bool hasMultiplexer;
    float chestGravityOffset;     // Resting z reading (g); used by the calibration checks
    float baseGravityOffset;
    GravityAxis chestAxis;        // Resting gravity direction; samples are projected onto it
    GravityAxis baseAxis;
    float lastFilteredNetAccel;
    uint32_t lastSampleMicros;

    // Non-blocking calibration accumulators
    float calChestSum;
    float calBaseSum;
    Vec3 calChestVecSum;
    Vec3 calBaseVecSum;
    uint16_t calSampleCount;
    bool isCalibrated;
    float calNetMin;          // Minimum raw net differential during calibration
    float calNetMax;          // Maximum raw net differential during calibration
    float calChestMin;        // Minimum raw chest reading during calibration
    float calChestMax;        // Maximum raw chest reading during calibration
    float calBaseMin;         // Minimum raw base reading during calibration
    float calBaseMax;         // Maximum raw base reading during calibration
    mutable uint8_t lastCalibrationFailureReason;

    // Sensor health: failed bus reads and frozen (identical) readings
    uint8_t  consecutiveReadFailures;
    uint16_t identicalSampleCount;
    float    lastChestZ;
    float    lastBaseZ;
    bool     sensorFault;
    uint32_t lastSampleSuccessMicros;
    uint32_t currentI2CSpeedHz;
    bool     useDualMpu;
    bool     baseSensorOnline;

public:
    SensorManager() 
        : chestMuxChannel(CPReadyConfig::PCA_CHANNEL_CHEST_DEFAULT),
          #if USE_DUAL_MPU
          baseMuxChannel(CPReadyConfig::PCA_CHANNEL_BASE_DEFAULT),
          #endif
          chestI2CAddr(CPReadyConfig::CHEST_MPU_I2C_ADDR),
          #if USE_DUAL_MPU
          baseI2CAddr(CPReadyConfig::BASE_MPU_I2C_ADDR),
          #endif
          hasMultiplexer(false),
          chestGravityOffset(0.0f), baseGravityOffset(0.0f),
          lastFilteredNetAccel(0.0f), lastSampleMicros(0),
          calChestSum(0.0f), calBaseSum(0.0f), calSampleCount(0), isCalibrated(false),
          calNetMin(999.0f), calNetMax(-999.0f),
          calChestMin(999.0f), calChestMax(-999.0f),
          calBaseMin(999.0f), calBaseMax(-999.0f),
          lastCalibrationFailureReason(ERR_NONE),
          consecutiveReadFailures(0), identicalSampleCount(0),
          lastChestZ(0.0f), lastBaseZ(0.0f), sensorFault(false),
          lastSampleSuccessMicros(0),
          currentI2CSpeedHz(CPReadyConfig::I2C_CLOCK_SPEED_HZ),
          useDualMpu(CPReadyConfig::DEFAULT_USE_DUAL_MPU),
          baseSensorOnline(false) {
        chestAxis.reset();
        baseAxis.reset();
        calChestVecSum = {0.0f, 0.0f, 0.0f};
        calBaseVecSum = {0.0f, 0.0f, 0.0f};
    }

    void setI2CSpeed(uint32_t speedHz) {
        currentI2CSpeedHz = (speedHz >= 400000) ? 400000 : 100000;
        Wire.setClock(currentI2CSpeedHz);
        Serial.printf("[I2C] Bus clock speed set to %lu Hz\n", (unsigned long)currentI2CSpeedHz);
    }
    uint32_t getI2CSpeed() const { return currentI2CSpeedHz; }

    void setUseDualMpu(bool dual) {
        useDualMpu = dual;
        Serial.printf("[SENSOR] Runtime sensor mode set to %s\n",
                      useDualMpu ? "2-MPU (Differential)" : "1-MPU (Chest Only)");
    }
    bool getUseDualMpu() const { return useDualMpu; }
    bool isBaseSensorOnline() const { return baseSensorOnline; }

    // Multiplexer Channel Switching Helpers (with capacitive settling delay)
    void selectMuxChannel(uint8_t channel) {
        if (!hasMultiplexer || channel > 7) return;
        Wire.beginTransmission(CPReadyConfig::PCA9548A_I2C_ADDR);
        Wire.write(1 << channel);
        Wire.endTransmission();
        delayMicroseconds(50); // Let newly connected channel bus line capacitance settle
    }

    void disableMux() {
        if (!hasMultiplexer) return;
        Wire.beginTransmission(CPReadyConfig::PCA9548A_I2C_ADDR);
        Wire.write(0x00);
        Wire.endTransmission();
        delayMicroseconds(50);
    }

    // Hardware I2C bus recovery routine (NXP UM10204 9-clock cycle sequence)
    // Toggles SCL up to 9 times to force any stuck slave to release SDA,
    // followed by generating a manual STOP condition before restarting Wire.
    void recoverI2CBus() {
        Wire.end();
        pinMode(CPReadyConfig::I2C_SDA_PIN, INPUT_PULLUP);
        pinMode(CPReadyConfig::I2C_SCL_PIN, OUTPUT);
        digitalWrite(CPReadyConfig::I2C_SCL_PIN, HIGH);
        delayMicroseconds(5);

        for (int i = 0; i < 9; i++) {
            if (digitalRead(CPReadyConfig::I2C_SDA_PIN) == HIGH) {
                break; // Slave released SDA line
            }
            digitalWrite(CPReadyConfig::I2C_SCL_PIN, LOW);
            delayMicroseconds(5);
            digitalWrite(CPReadyConfig::I2C_SCL_PIN, HIGH);
            delayMicroseconds(5);
        }

        // Generate explicit STOP condition (SDA low while SCL high, then SDA high)
        pinMode(CPReadyConfig::I2C_SDA_PIN, OUTPUT);
        digitalWrite(CPReadyConfig::I2C_SDA_PIN, LOW);
        delayMicroseconds(5);
        digitalWrite(CPReadyConfig::I2C_SCL_PIN, HIGH);
        delayMicroseconds(5);
        digitalWrite(CPReadyConfig::I2C_SDA_PIN, HIGH);
        delayMicroseconds(5);

        pinMode(CPReadyConfig::I2C_SDA_PIN, INPUT_PULLUP);
        pinMode(CPReadyConfig::I2C_SCL_PIN, INPUT_PULLUP);

        Wire.begin(CPReadyConfig::I2C_SDA_PIN, CPReadyConfig::I2C_SCL_PIN);
        Wire.setClock(currentI2CSpeedHz);
        Wire.setTimeOut(CPReadyConfig::I2C_TIMEOUT_MS);
    }

    // Hardware I2C bus recovery routine for downstream channels behind PCA9548A multiplexer.
    // If an MPU6050 hung while being read, it may hold its channel's SDA low.
    // By selecting the channel first, SCL clock pulses will pass through the PCA9548A FET pass-gate
    // directly to the downstream sensor to clock out the stuck ACK/data bit.
    void recoverDownstreamBus() {
        if (!hasMultiplexer) return;

        for (uint8_t ch = 0; ch < 8; ch++) {
            Wire.beginTransmission(CPReadyConfig::PCA9548A_I2C_ADDR);
            Wire.write(1 << ch);
            if (Wire.endTransmission() != 0) {
                continue;
            }
            delayMicroseconds(50);

            // If downstream slave is holding SDA low, clock SCL up to 9 times through the pass-FET
            if (digitalRead(CPReadyConfig::I2C_SDA_PIN) == LOW) {
                Serial.printf("[I2C MUX] Downstream channel SD%d SDA stuck LOW. Clocking recovery pulses...\n", ch);
                Wire.end();
                pinMode(CPReadyConfig::I2C_SDA_PIN, INPUT_PULLUP);
                pinMode(CPReadyConfig::I2C_SCL_PIN, OUTPUT);
                digitalWrite(CPReadyConfig::I2C_SCL_PIN, HIGH);
                delayMicroseconds(5);

                for (int i = 0; i < 9; i++) {
                    if (digitalRead(CPReadyConfig::I2C_SDA_PIN) == HIGH) {
                        break;
                    }
                    digitalWrite(CPReadyConfig::I2C_SCL_PIN, LOW);
                    delayMicroseconds(5);
                    digitalWrite(CPReadyConfig::I2C_SCL_PIN, HIGH);
                    delayMicroseconds(5);
                }

                // Generate explicit STOP condition
                pinMode(CPReadyConfig::I2C_SDA_PIN, OUTPUT);
                digitalWrite(CPReadyConfig::I2C_SDA_PIN, LOW);
                delayMicroseconds(5);
                digitalWrite(CPReadyConfig::I2C_SCL_PIN, HIGH);
                delayMicroseconds(5);
                digitalWrite(CPReadyConfig::I2C_SDA_PIN, HIGH);
                delayMicroseconds(5);

                pinMode(CPReadyConfig::I2C_SDA_PIN, INPUT_PULLUP);
                pinMode(CPReadyConfig::I2C_SCL_PIN, INPUT_PULLUP);

                Wire.begin(CPReadyConfig::I2C_SDA_PIN, CPReadyConfig::I2C_SCL_PIN);
                Wire.setClock(currentI2CSpeedHz);
                Wire.setTimeOut(CPReadyConfig::I2C_TIMEOUT_MS);
            }
        }
        disableMux();
    }

    // Automated boot-time I2C bus diagnostic scanner
    void scanI2CBus() const {
        Serial.printf("[I2C SCAN] Probing I2C bus (SDA=GPIO%d, SCL=GPIO%d, Speed=%lu Hz)...\n",
            CPReadyConfig::I2C_SDA_PIN, CPReadyConfig::I2C_SCL_PIN, (unsigned long)currentI2CSpeedHz);
        uint8_t count = 0;
        for (uint8_t addr = 1; addr < 127; addr++) {
            Wire.beginTransmission(addr);
            uint8_t error = Wire.endTransmission();
            if (error == 0) {
                Serial.printf("[I2C SCAN]  -> Device detected at address 0x%02X", addr);
                if (addr == 0x68) {
                    Serial.print(" (MPU-6050 Default / 0x68)");
                } else if (addr == 0x69) {
                    Serial.print(" (MPU-6050 Alternate / 0x69)");
                } else if (addr == CPReadyConfig::PCA9548A_I2C_ADDR) {
                    Serial.print(" (PCA9548A I2C Multiplexer)");
                }
                Serial.println();
                count++;
            }
        }
        if (count == 0) {
            Serial.println("[I2C SCAN]  -> [WARN] No I2C devices found! Check VCC/5V power, GND, and SDA/SCL wires.");
        } else {
            Serial.printf("[I2C SCAN]  -> Scan complete: %d device(s) found.\n", count);
        }
    }

    // Automated boot-time diagnostic scanner across all 8 downstream multiplexer channels
    void scanMultiplexerChannels() {
        if (!hasMultiplexer) return;
        Serial.println("[MUX SCAN] Probing all 8 downstream PCA9548A multiplexer channels (SD0-SD7)...");
        uint8_t totalDevicesAcrossChannels = 0;

        for (uint8_t ch = 0; ch < 8; ch++) {
            selectMuxChannel(ch);
            uint8_t chDevices = 0;

            for (uint8_t addr = 1; addr < 127; addr++) {
                // Skip the multiplexer's own address to avoid echoing upstream bus traffic
                if (addr == CPReadyConfig::PCA9548A_I2C_ADDR) continue;

                Wire.beginTransmission(addr);
                if (Wire.endTransmission() == 0) {
                    if (chDevices == 0) {
                        Serial.printf("[MUX SCAN]  -> Channel SD%d:\n", ch);
                    }
                    Serial.printf("        * Device at 0x%02X", addr);
                    if (addr == 0x68) {
                        Serial.print(" (MPU-6050 Default / 0x68)");
                    } else if (addr == 0x69) {
                        Serial.print(" (MPU-6050 Alternate / 0x69)");
                    }

                    // Query WHO_AM_I register for MPU devices
                    if (addr == 0x68 || addr == 0x69) {
                        Wire.beginTransmission(addr);
                        Wire.write(0x75);
                        if (Wire.endTransmission(false) == 0 && Wire.requestFrom((int)addr, 1) == 1) {
                            uint8_t whoAmI = Wire.read();
                            const char* tag = (whoAmI == 0x68) ? " - MPU6050 Genuine" 
                                            : (whoAmI == 0x70 || whoAmI == 0x72 ? " - MPU6500/Clone" : "");
                            Serial.printf(" [WHO_AM_I: 0x%02X%s]", whoAmI, tag);
                        }
                    }
                    Serial.println();
                    chDevices++;
                    totalDevicesAcrossChannels++;
                }
            }
        }
        disableMux();

        if (totalDevicesAcrossChannels == 0) {
            Serial.println("[MUX SCAN]  -> [WARN] No devices found across any downstream multiplexer channel!");
        } else {
            Serial.printf("[MUX SCAN]  -> Downstream scan complete: %d device(s) found across all channels.\n", totalDevicesAcrossChannels);
        }
    }

    // Dynamic PCA9548A channel scanner & automatic mapping (with multi-address & retry support)
    bool detectAndMapChannels() {
        Wire.beginTransmission(CPReadyConfig::PCA9548A_I2C_ADDR);
        if (Wire.endTransmission() != 0) {
            hasMultiplexer = false;
            return false;
        }
        hasMultiplexer = true;

        int8_t detectedChannels[8];
        uint8_t detectedAddresses[8];
        uint8_t detectedCount = 0;

        const uint8_t candidateAddrs[] = {0x68, 0x69};

        for (uint8_t ch = 0; ch < 8; ch++) {
            selectMuxChannel(ch);

            for (uint8_t a = 0; a < 2; a++) {
                uint8_t probeAddr = candidateAddrs[a];
                bool foundOnChannel = false;

                // Up to 3 retries per candidate address to reject transient contact bounce or wire noise
                for (uint8_t attempt = 0; attempt < 3; attempt++) {
                    Wire.beginTransmission(probeAddr);
                    if (Wire.endTransmission() == 0) {
                        foundOnChannel = true;
                        break;
                    }
                    delay(2);
                }

                if (foundOnChannel) {
                    detectedChannels[detectedCount] = ch;
                    detectedAddresses[detectedCount] = probeAddr;
                    detectedCount++;

                    // Query WHO_AM_I register (0x75) for diagnostic transparency
                    uint8_t whoAmI = 0x00;
                    Wire.beginTransmission(probeAddr);
                    Wire.write(0x75);
                    if (Wire.endTransmission(false) == 0) {
                        if (Wire.requestFrom((int)probeAddr, 1) == 1) {
                            whoAmI = Wire.read();
                        }
                    }

                    const char* chipTag = (whoAmI == 0x68) ? " - MPU6050 Genuine" 
                                        : (whoAmI == 0x70 || whoAmI == 0x72 ? " - MPU6500/Clone" : "");
                    Serial.printf("[I2C MUX]  -> Channel SD%d: Mapped to 0x%02X (WHO_AM_I: 0x%02X%s)\n",
                        ch, probeAddr, whoAmI, chipTag);
                    break; // Sensor found on this channel, advance to next channel
                }
            }
        }
        disableMux();

        if (detectedCount == 0) {
            Serial.println("[I2C MUX WARN] Multiplexer found, but NO MPU6050 sensors detected on any channel (SD0-SD7)!");
            return false;
        }

        // 1. Assign chest sensor channel (prefers default SD3 if detected)
        bool chestFound = false;
        for (uint8_t i = 0; i < detectedCount; i++) {
            if (detectedChannels[i] == CPReadyConfig::PCA_CHANNEL_CHEST_DEFAULT) {
                chestMuxChannel = CPReadyConfig::PCA_CHANNEL_CHEST_DEFAULT;
                chestI2CAddr = detectedAddresses[i];
                chestFound = true;
                break;
            }
        }
        if (!chestFound) {
            chestMuxChannel = detectedChannels[0];
            chestI2CAddr = detectedAddresses[0];
            Serial.printf("[I2C MUX] Chest sensor not on default SD%d; auto-mapped to SD%d (0x%02X).\n",
                CPReadyConfig::PCA_CHANNEL_CHEST_DEFAULT, chestMuxChannel, chestI2CAddr);
        } else {
            Serial.printf("[I2C MUX] Chest sensor mapped to SD%d (0x%02X).\n", chestMuxChannel, chestI2CAddr);
        }

        #if USE_DUAL_MPU
        if (detectedCount < 2) {
            baseSensorOnline = false;
            if (useDualMpu) {
                Serial.printf("[I2C MUX WARN] Dual MPU mode requested, but only %d MPU sensor detected!\n", detectedCount);
                return false;
            }
            Serial.println("[I2C MUX] Single MPU detected; running in 1-MPU (Chest Only) mode.");
            return true;
        }

        // 2. Assign base sensor channel (prefers default SD2 if detected and not chest)
        bool baseFound = false;
        for (uint8_t i = 0; i < detectedCount; i++) {
            if (detectedChannels[i] == CPReadyConfig::PCA_CHANNEL_BASE_DEFAULT &&
                detectedChannels[i] != chestMuxChannel) {
                baseMuxChannel = CPReadyConfig::PCA_CHANNEL_BASE_DEFAULT;
                baseI2CAddr = detectedAddresses[i];
                baseFound = true;
                break;
            }
        }
        if (!baseFound) {
            for (uint8_t i = 0; i < detectedCount; i++) {
                if (detectedChannels[i] != chestMuxChannel) {
                    baseMuxChannel = detectedChannels[i];
                    baseI2CAddr = detectedAddresses[i];
                    break;
                }
            }
            Serial.printf("[I2C MUX] Base sensor not on default SD%d; auto-mapped to SD%d (0x%02X).\n",
                CPReadyConfig::PCA_CHANNEL_BASE_DEFAULT, baseMuxChannel, baseI2CAddr);
        } else {
            Serial.printf("[I2C MUX] Base sensor mapped to SD%d (0x%02X).\n", baseMuxChannel, baseI2CAddr);
        }
        baseSensorOnline = true;
        #endif

        return true;
    }

    bool begin() {
#ifdef FAKE_SENSORS
        hasMultiplexer = false;
        chestMuxChannel = 0;
        chestI2CAddr = 0x68;
        #if USE_DUAL_MPU
        baseMuxChannel = 0;
        baseI2CAddr = 0x69;
        #endif
        consecutiveReadFailures = 0;
        identicalSampleCount = 0;
        sensorFault = false;
        lastChestZ = -999.0f;
        lastBaseZ = -999.0f;
        Serial.println("[FAKE] Sensor init bypassed — no I2C hardware required.");
        return true;
#else
        consecutiveReadFailures = 0;
        identicalSampleCount = 0;
        sensorFault = false;

        delay(50); // Power-on stabilization delay for MPU-6050 and PCA9548A internal POR
        recoverI2CBus();
        scanI2CBus();

        // Check if PCA9548A multiplexer is online at 0x70
        Wire.beginTransmission(CPReadyConfig::PCA9548A_I2C_ADDR);
        hasMultiplexer = (Wire.endTransmission() == 0);

        if (hasMultiplexer) {
            Serial.printf("[I2C MUX] PCA9548A Multiplexer detected at address 0x%02X.\n", CPReadyConfig::PCA9548A_I2C_ADDR);
            recoverDownstreamBus();
            scanMultiplexerChannels();

            bool muxDetected = detectAndMapChannels();
            if (!muxDetected) {
                disableMux();
                return false;
            }

            // Initialize chest sensor behind its multiplexer channel
            selectMuxChannel(chestMuxChannel);
            if (!chestSensor.begin(chestI2CAddr, &Wire)) {
                Serial.printf("[ERROR] Failed to initialize Chest MPU6050 on Mux SD%d (address 0x%02X)!\n", 
                    chestMuxChannel, chestI2CAddr);
                disableMux();
                return false;
            }
            chestSensor.setAccelerometerRange(MPU6050_RANGE_4_G);
            chestSensor.setFilterBandwidth(MPU6050_BAND_44_HZ);

            #if USE_DUAL_MPU
            if (baseSensorOnline) {
                // Initialize base sensor behind its multiplexer channel
                selectMuxChannel(baseMuxChannel);
                if (!baseSensor.begin(baseI2CAddr, &Wire)) {
                    baseSensorOnline = false;
                    if (useDualMpu) {
                        Serial.printf("[ERROR] Failed to initialize Base MPU6050 on Mux SD%d (address 0x%02X)!\n", 
                            baseMuxChannel, baseI2CAddr);
                        disableMux();
                        return false;
                    }
                    Serial.printf("[WARN] Base MPU6050 on Mux SD%d unavailable; continuing in 1-MPU (Chest Only) mode.\n",
                        baseMuxChannel);
                } else {
                    baseSensor.setAccelerometerRange(MPU6050_RANGE_4_G);
                    baseSensor.setFilterBandwidth(MPU6050_BAND_44_HZ);
                }
            }
            #endif

            disableMux();
            return true;
        } else {
            // Direct bus fallback (without multiplexer)
            #if USE_DUAL_MPU
            // Shared-bus wiring from the hardware guide: chest AD0 -> GND (0x68),
            // base AD0 -> 3.3V (0x69).
            Wire.beginTransmission(0x68);
            bool chestPresent = (Wire.endTransmission() == 0);
            Wire.beginTransmission(0x69);
            bool basePresent = (Wire.endTransmission() == 0);
            if (!chestPresent && !basePresent) {
                Serial.println("[ERROR] No MPU6050 found on the main bus at 0x68 or 0x69.");
                return false;
            }
            if (useDualMpu && (!chestPresent || !basePresent)) {
                Serial.println("[ERROR] Dual MPU mode needs either a PCA9548A at 0x70 or two MPUs on the main bus at 0x68 (chest) and 0x69 (base).");
                return false;
            }
            chestI2CAddr = chestPresent ? 0x68 : 0x69;
            if (!chestSensor.begin(chestI2CAddr, &Wire)) {
                Serial.println("[ERROR] Failed to initialize the chest MPU on the main bus!");
                return false;
            }
            chestSensor.setAccelerometerRange(MPU6050_RANGE_4_G);
            chestSensor.setFilterBandwidth(MPU6050_BAND_44_HZ);

            baseSensorOnline = false;
            if (chestPresent && basePresent) {
                baseI2CAddr = 0x69;
                if (baseSensor.begin(baseI2CAddr, &Wire)) {
                    baseSensor.setAccelerometerRange(MPU6050_RANGE_4_G);
                    baseSensor.setFilterBandwidth(MPU6050_BAND_44_HZ);
                    baseSensorOnline = true;
                    Serial.println("[I2C] Direct bus dual sensors initialized: chest 0x68, base 0x69.");
                } else if (useDualMpu) {
                    Serial.println("[ERROR] Failed to initialize the base MPU at 0x69!");
                    return false;
                }
            } else {
                Serial.printf("[I2C] Direct bus 1-MPU mode: chest initialized at 0x%02X.\n", chestI2CAddr);
            }
            return true;
            #else
            uint8_t directAddr = CPReadyConfig::CHEST_MPU_I2C_ADDR;
            Wire.beginTransmission(directAddr);
            if (Wire.endTransmission() != 0) {
                // Try alternate address 0x69
                Wire.beginTransmission(0x69);
                if (Wire.endTransmission() == 0) {
                    directAddr = 0x69;
                }
            }
            chestI2CAddr = directAddr;
            Serial.printf("[I2C] Direct bus mode (no multiplexer): initializing chest sensor at 0x%02X...\n", directAddr);
            if (!chestSensor.begin(directAddr, &Wire)) {
                return false;
            }
            chestSensor.setAccelerometerRange(MPU6050_RANGE_4_G);
            chestSensor.setFilterBandwidth(MPU6050_BAND_44_HZ);
            return true;
            #endif
        }
#endif
    }

    // Prepare non-blocking calibration state
    void resetCalibration() {
        calChestSum = 0.0f;
        calBaseSum = 0.0f;
        calChestVecSum = {0.0f, 0.0f, 0.0f};
        calBaseVecSum = {0.0f, 0.0f, 0.0f};
        calSampleCount = 0;
        isCalibrated = false;
        calNetMin = 999.0f;
        calNetMax = -999.0f;
        calChestMin = 999.0f;
        calChestMax = -999.0f;
        calBaseMin = 999.0f;
        calBaseMax = -999.0f;
        lastCalibrationFailureReason = ERR_NONE;

        // Clear fault and stuck counters so idle standby glitches don't bleed into calibration
        consecutiveReadFailures = 0;
        identicalSampleCount = 0;
        sensorFault = false;
        lastChestZ = -999.0f;
        lastBaseZ = -999.0f;
        lastSampleSuccessMicros = 0;
        // Reset the sample-rate grid so calibration starts on a clean 100 Hz boundary,
        // preventing carry-over timing from previous sessions from skewing the sample count.
        lastSampleMicros = 0;
    }

    // True once reads have failed SENSOR_FAULT_CONSECUTIVE_FAILS times in a row or the
    // readings froze. Cleared only by begin()/reinitialize().
    bool hasFault() const { return sensorFault; }

    // Bus recovery plus full sensor re-initialisation, used to leave FAULT_ERROR.
    bool reinitialize() {
        Serial.println("[I2C] Re-initializing sensors after a fault...");
        consecutiveReadFailures = 0;
        identicalSampleCount = 0;
        sensorFault = false;
        lastChestZ = -999.0f;
        lastBaseZ = -999.0f;
        return begin();
    }

    // Called periodically during the idle baseline window (with optional 100 Hz rate limiting)
    bool recordCalibrationSample(uint32_t currentMicros = 0) {
        if (currentMicros > 0) {
            if (!sampleDue(currentMicros)) {
                return false;
            }
        }

        Vec3 chest, base;
        if (!readSensors(chest, base, false)) { // Bypass frozen check during motionless calibration
            return false; // Failed samples are not counted; too many end in a fault
        }
        const float a1 = chest.z;
        const float a2 = base.z;

        calChestSum += a1;
        calChestVecSum.x += chest.x;
        calChestVecSum.y += chest.y;
        calChestVecSum.z += chest.z;
        calSampleCount++;

        // Track single-sensor extremes
        if (a1 < calChestMin) calChestMin = a1;
        if (a1 > calChestMax) calChestMax = a1;

        #if USE_DUAL_MPU
        if (baseSensorOnline) {
            calBaseSum  += a2;
            calBaseVecSum.x += base.x;
            calBaseVecSum.y += base.y;
            calBaseVecSum.z += base.z;

            if (a2 < calBaseMin) calBaseMin = a2;
            if (a2 > calBaseMax) calBaseMax = a2;
        }

        float netSample = (useDualMpu && baseSensorOnline) ? -(a1 - a2) : -a1;
        #else
        float netSample = -a1;
        #endif

        // Track raw differential spread for motion stability validation
        if (netSample < calNetMin) calNetMin = netSample;
        if (netSample > calNetMax) calNetMax = netSample;
        return true;
    }

    // Finalize calculated static gravity baseline
    void finalizeCalibration() {
        if (calSampleCount > 0) {
            const float n = (float)calSampleCount;
            chestGravityOffset = calChestSum / n;
            chestAxis.setFromRest({calChestVecSum.x / n, calChestVecSum.y / n, calChestVecSum.z / n});
            #if USE_DUAL_MPU
            if (baseSensorOnline) {
                baseGravityOffset  = calBaseSum  / n;
                baseAxis.setFromRest({calBaseVecSum.x / n, calBaseVecSum.y / n, calBaseVecSum.z / n});
                Serial.printf("[CALIB] Sensor tilt from vertical: chest %.1f deg, base %.1f deg (mode=%s)\n",
                              chestAxis.tiltDegrees(), baseAxis.tiltDegrees(),
                              useDualMpu ? "2-MPU" : "1-MPU");
            } else {
                baseGravityOffset = 0.0f;
                baseAxis.reset();
                Serial.printf("[CALIB] Chest sensor tilt from vertical: %.1f deg (1-MPU)\n",
                              chestAxis.tiltDegrees());
            }
            #else
            baseGravityOffset  = 0.0f;
            Serial.printf("[CALIB] Chest sensor tilt from vertical: %.1f deg\n", chestAxis.tiltDegrees());
            #endif
            isCalibrated = true;
        }
        // The smoothing filter restarts from the new baseline instead of carrying the
        // previous session's state into the first strokes.
        lastFilteredNetAccel = 0.0f;
    }

    // Multi-tier calibration verification: sample count, motion spread, gravity sanity, and sensor alignment
    bool isCalibrationStable() const {
        if (calSampleCount < CPReadyConfig::CALIBRATION_MIN_SAMPLE_COUNT) {
            lastCalibrationFailureReason = ERR_LOW_SAMPLE_COUNT;
            Serial.printf("[CALIB FAIL] Sample count low: %d / %d\n", calSampleCount, CPReadyConfig::CALIBRATION_SAMPLE_COUNT);
            return false;
        }
        if ((calNetMax - calNetMin) > CPReadyConfig::CALIBRATION_MAX_NET_SPREAD_G) {
            lastCalibrationFailureReason = ERR_MOTION_UNSTABLE;
            Serial.printf("[CALIB FAIL] Net motion spread: %.2fg > %.2fg\n", (calNetMax - calNetMin), CPReadyConfig::CALIBRATION_MAX_NET_SPREAD_G);
            return false;
        }
        if ((calChestMax - calChestMin) > CPReadyConfig::CALIBRATION_MAX_CHEST_SPREAD_G) {
            lastCalibrationFailureReason = ERR_MOTION_UNSTABLE;
            Serial.printf("[CALIB FAIL] Chest motion spread: %.2fg > %.2fg\n", (calChestMax - calChestMin), CPReadyConfig::CALIBRATION_MAX_CHEST_SPREAD_G);
            return false;
        }
        const float chestMagG = chestAxis.magnitude() > 0.0f ? chestAxis.magnitude() : fabsf(chestGravityOffset);
        if (chestMagG < CPReadyConfig::CALIBRATION_GRAVITY_MIN_G || chestMagG > CPReadyConfig::CALIBRATION_GRAVITY_MAX_G) {
            lastCalibrationFailureReason = ERR_GRAVITY_IMPLAUSIBLE;
            Serial.printf("[CALIB FAIL] Chest gravity magnitude implausible: %.2fg (z=%.2fg)\n", chestMagG, chestGravityOffset);
            return false;
        }

        #if USE_DUAL_MPU
        if (useDualMpu && baseSensorOnline) {
            if ((calBaseMax - calBaseMin) > CPReadyConfig::CALIBRATION_MAX_BASE_SPREAD_G) {
                lastCalibrationFailureReason = ERR_MOTION_UNSTABLE;
                Serial.printf("[CALIB FAIL] Base motion spread: %.2fg > %.2fg\n", (calBaseMax - calBaseMin), CPReadyConfig::CALIBRATION_MAX_BASE_SPREAD_G);
                return false;
            }
            const float baseMagG = baseAxis.magnitude() > 0.0f ? baseAxis.magnitude() : fabsf(baseGravityOffset);
            if (baseMagG < CPReadyConfig::CALIBRATION_GRAVITY_MIN_G || baseMagG > CPReadyConfig::CALIBRATION_GRAVITY_MAX_G) {
                lastCalibrationFailureReason = ERR_GRAVITY_IMPLAUSIBLE;
                Serial.printf("[CALIB FAIL] Base gravity magnitude implausible: %.2fg (z=%.2fg)\n", baseMagG, baseGravityOffset);
                return false;
            }
            if (fabsf(chestGravityOffset - baseGravityOffset) > CPReadyConfig::CALIBRATION_MAX_ALIGNMENT_DIFF_G) {
                lastCalibrationFailureReason = ERR_SENSOR_ALIGNMENT;
                Serial.printf("[CALIB FAIL] Tilt/pre-pressure divergence: %.2fg > %.2fg\n", 
                    fabsf(chestGravityOffset - baseGravityOffset), CPReadyConfig::CALIBRATION_MAX_ALIGNMENT_DIFF_G);
                return false;
            }
        }
        #endif

        lastCalibrationFailureReason = ERR_NONE;
        return true;
    }

    uint8_t getCalibrationFailureReason() const { return lastCalibrationFailureReason; }

    // Primary sampling function intended to run at configured rate (default 100 Hz).
    // Returns false when no sample is due or the sensor read failed.
    // outNetAccel is low-pass filtered for stroke detection; outRawNetAccel is the same
    // sample unfiltered, for depth integration. Both are vertical (along the gravity
    // direction learned at calibration), so a tilted pad does not under-read.
    // outDtSeconds provides the actual elapsed time for exact Riemann double integration.
    // outRaw, when supplied, receives the same I2C read as unfiltered chest/base milli-g.
    bool sample100Hz(float& outNetAccel, float& outRawNetAccel, float& outDtSeconds,
                     uint32_t currentMicros, TelemetryFrames::SensorRawSample* outRaw = nullptr) {
        if (!sampleDue(currentMicros)) {
            return false; // Not time yet (non-blocking)
        }

        Vec3 chest, base;
        if (!readSensors(chest, base)) {
            return false;
        }

        if (outRaw != nullptr) {
            outRaw->t_us = currentMicros;
            outRaw->chest_mg[0] = toMilliG(chest.x);
            outRaw->chest_mg[1] = toMilliG(chest.y);
            outRaw->chest_mg[2] = toMilliG(chest.z);
            outRaw->base_mg[0] = toMilliG(base.x);
            outRaw->base_mg[1] = toMilliG(base.y);
            outRaw->base_mg[2] = toMilliG(base.z);
        }

        uint32_t dtMicros = (lastSampleSuccessMicros > 0 && currentMicros > lastSampleSuccessMicros)
            ? (currentMicros - lastSampleSuccessMicros)
            : CPReadyConfig::SAMPLE_INTERVAL_MICROS;
        lastSampleSuccessMicros = currentMicros;
        outDtSeconds = (float)dtMicros / 1000000.0f;

        float aChestG = chestAxis.dynamicG(chest);

        #if USE_DUAL_MPU
        float aBaseG  = baseSensorOnline ? baseAxis.dynamicG(base) : 0.0f;
        float rawNet  = (useDualMpu && baseSensorOnline) ? -(aChestG - aBaseG) : -aChestG;
        #else
        float rawNet  = -aChestG;
        #endif

        // Low-pass exponential smoothing filter
        const float alpha = CPReadyConfig::LOWPASS_FILTER_ALPHA;
        lastFilteredNetAccel = (alpha * rawNet) + ((1.0f - alpha) * lastFilteredNetAccel);
        outNetAccel = lastFilteredNetAccel;
        outRawNetAccel = rawNet;
        return true;
    }

    bool sample100Hz(float& outNetAccel, float& outRawNetAccel, uint32_t currentMicros) {
        float dummyDt = 0.01f;
        return sample100Hz(outNetAccel, outRawNetAccel, dummyDt, currentMicros);
    }

private:
    static int16_t toMilliG(float g) {
        const float mg = g * 1000.0f;
        if (mg > 32767.0f) return 32767;
        if (mg < -32768.0f) return -32768;
        return (int16_t)lroundf(mg);
    }

    // Fixed-rate scheduler: advances by whole intervals so loop jitter does not lower
    // the sample rate, but never tries to catch up on more than one missed sample.
    bool sampleDue(uint32_t currentMicros) {
        if (currentMicros - lastSampleMicros < CPReadyConfig::SAMPLE_INTERVAL_MICROS) {
            return false;
        }
        lastSampleMicros += CPReadyConfig::SAMPLE_INTERVAL_MICROS;
        if (currentMicros - lastSampleMicros >= CPReadyConfig::SAMPLE_INTERVAL_MICROS) {
            lastSampleMicros = currentMicros;
        }
        return true;
    }

    // Reads all three axes of both sensors in g. Returns false on a failed bus read;
    // repeated failures or frozen readings latch sensorFault.
#ifdef FAKE_SENSORS
    bool readSensors(Vec3& chest, Vec3& base, bool checkFrozen = true) {
        const float t = 0.001f * lastSampleMicros;
        const float gravity = 1.0f;
        const float rate = 3.14159f * 100.0f / 30.0f;
        chest.x = 0.02f * sinf(rate * t);
        chest.y = 0.0f;
        chest.z = gravity + 0.04f * sinf(rate * t);
        base.x = 0.0f;
        base.y = 0.0f;
        base.z = gravity;
        consecutiveReadFailures = 0;
        identicalSampleCount = 0;
        lastChestZ = chest.z;
        lastBaseZ = base.z;
        return true;
    }
#else
    bool readSensors(Vec3& chest, Vec3& base, bool checkFrozen = true) {
        selectMuxChannel(chestMuxChannel);
        sensors_event_t aChest, gChest, tempChest;
        bool ok = chestSensor.getEvent(&aChest, &gChest, &tempChest);
        chest.x = aChest.acceleration.x / SENSORS_GRAVITY_STANDARD;
        chest.y = aChest.acceleration.y / SENSORS_GRAVITY_STANDARD;
        chest.z = aChest.acceleration.z / SENSORS_GRAVITY_STANDARD;

        #if USE_DUAL_MPU
        if (baseSensorOnline) {
            selectMuxChannel(baseMuxChannel);
            sensors_event_t aBase, gBase, tempBase;
            bool baseOk = baseSensor.getEvent(&aBase, &gBase, &tempBase);
            if (baseOk) {
                base.x = aBase.acceleration.x / SENSORS_GRAVITY_STANDARD;
                base.y = aBase.acceleration.y / SENSORS_GRAVITY_STANDARD;
                base.z = aBase.acceleration.z / SENSORS_GRAVITY_STANDARD;
            } else {
                base = {0.0f, 0.0f, 0.0f};
                if (useDualMpu) {
                    ok = false;
                }
            }
        } else {
            base = {0.0f, 0.0f, 0.0f};
            if (useDualMpu) {
                ok = false;
            }
        }
        #else
        base = {0.0f, 0.0f, 0.0f};
        #endif
        const float chestZ = chest.z;
        const float baseZ = base.z;

        if (!ok) {
            if (consecutiveReadFailures < 255) consecutiveReadFailures++;
            if (consecutiveReadFailures >= CPReadyConfig::SENSOR_FAULT_CONSECUTIVE_FAILS && !sensorFault) {
                sensorFault = true;
                Serial.println("[I2C FAULT] Sensor reads keep failing. Check the sensor cables.");
            }
            return false;
        }
        consecutiveReadFailures = 0;

        // A sensor that lost power and came back sits in sleep mode and returns its last
        // register contents forever. Real readings always carry a few LSB of noise.
        // During stationary baseline calibration, identical readings on a still surface are normal and checked by gravity limits.
        if (checkFrozen) {
            const bool frozen = (useDualMpu && baseSensorOnline)
                ? (chestZ == lastChestZ && baseZ == lastBaseZ)
                : (chestZ == lastChestZ);
            if (frozen) {
                if (identicalSampleCount < 0xFFFF) identicalSampleCount++;
                if (identicalSampleCount >= CPReadyConfig::SENSOR_STUCK_SAMPLE_LIMIT && !sensorFault) {
                    sensorFault = true;
                    Serial.println("[I2C FAULT] Sensor readings are frozen (sensor reset or asleep).");
                }
            } else {
                identicalSampleCount = 0;
            }
        } else {
            identicalSampleCount = 0;
        }
        lastChestZ = chestZ;
        lastBaseZ = baseZ;
        return true;
    }
#endif

public:
    bool getIsCalibrated() const { return isCalibrated; }
    bool getHasMultiplexer() const { return hasMultiplexer; }
    uint8_t getChestChannel() const { return chestMuxChannel; }
    uint8_t getChestI2CAddress() const { return chestI2CAddr; }
    #if USE_DUAL_MPU
    uint8_t getBaseChannel() const { return baseMuxChannel; }
    uint8_t getBaseI2CAddress() const { return baseI2CAddr; }
    #endif
};

#endif // SENSOR_MANAGER_H
