Marni3/CPReady/CPReady_Program/include/BLEReadings.h

#ifndef BLE_READINGS_H
#define BLE_READINGS_H

#include <Arduino.h>

/**
 * ==============================================================================
 * CPReady BLE Telemetry & Packet Specification
 * ==============================================================================
 * 
 * PACKET SIZE: Exactly 16 Bytes (Packed Little-Endian)
 *   Bytes 0..11 keep the original 12-byte layout. Bytes 12..15 (protocol v2) add an
 *   unsaturated 16-bit stroke count and a notification sequence number, so the app can
 *   count compressions past 255 and measure lost packets.
 * SERVICE UUID:        6e400001-b5a3-f393-e0a9-e50e24dcca9e
 * METRICS CHAR UUID:   6e400002-b5a3-f393-e0a9-e50e24dcca9e
 * COMMAND CHAR UUID:   6e400003-b5a3-f393-e0a9-e50e24dcca9e
 * ==============================================================================
 */

// Packet Type Identifiers (Byte 0)
constexpr uint8_t PKT_TYPE_REALTIME       = 1; // Ordinary real-time telemetry (per-stroke or 5 Hz)
constexpr uint8_t PKT_TYPE_CALIB_PROGRESS = 2; // Baseline calibration underway (hands still on chest)
constexpr uint8_t PKT_TYPE_CALIB_SUCCESS  = 3; // Baseline calibration completed (signal for app to show 'Begin Compressions')
constexpr uint8_t PKT_TYPE_FINAL_SUMMARY  = 4; // Finalized session results summary (triggers auto-save in Flutter)
constexpr uint8_t PKT_TYPE_ERROR          = 5; // Error condition (e.g. sensor failure or excessive calibration motion)
constexpr uint8_t PKT_TYPE_CONFIG_REPORT  = 6; // Device configuration report (profile, depth K, durations)

// Audio Coaching Cue Codes (Byte 7 for PKT_TYPE_REALTIME / FINAL_SUMMARY) - Generated by ESP32, Played by Phone Speaker
constexpr uint8_t PROMPT_NONE             = 0; // No audio guidance (cooldown active or target met)
constexpr uint8_t PROMPT_PUSH_HARDER      = 1; // "Push harder" (depth < 50 mm sustained >= 3.5s)
constexpr uint8_t PROMPT_PUSH_LESS        = 2; // "Push shallower" (depth > 60 mm sustained >= 3.5s)
constexpr uint8_t PROMPT_RELEASE_FULLY    = 3; // "Release chest completely" (leaning / recoil < -0.35g sustained >= 3.5s)
constexpr uint8_t PROMPT_SPEED_UP         = 4; // "Speed up" (rate < 100 cpm sustained >= 3.5s)
constexpr uint8_t PROMPT_SLOW_DOWN        = 5; // "Slow down" (rate > 120 cpm sustained >= 3.5s)
constexpr uint8_t PROMPT_GOOD_JOB         = 6; // "Good compressions" (positive praise after sustained target compliance)

// System & Calibration Error Reason Codes (Byte 7 when packet_type is PKT_TYPE_ERROR)
constexpr uint8_t ERR_NONE                = 0; // Unspecified error
constexpr uint8_t ERR_MOTION_UNSTABLE     = 1; // Motion spread exceeded limit (>0.25g chest / >0.30g net)
constexpr uint8_t ERR_LOW_SAMPLE_COUNT    = 2; // Incomplete sample window (<150 of 200 samples)
constexpr uint8_t ERR_GRAVITY_IMPLAUSIBLE = 3; // Static gravity outside plausible range (0.65g - 1.35g)
constexpr uint8_t ERR_SENSOR_ALIGNMENT    = 4; // Sensor divergence / tilt misalignment (>0.35g)
constexpr uint8_t ERR_WRONG_STATE         = 5; // Command rejected due to conflicting device state
constexpr uint8_t ERR_NO_TRIAL_DATA       = 6; // Calibration target requested without completed session
constexpr uint8_t ERR_I2C_FAULT           = 7; // I2C communication fault or sensor unreadable
constexpr uint8_t ERR_CALIB_OUT_OF_RANGE  = 8; // Target depth ratio or resulting K outside supported bounds

// Cadence Quality & Engine State Bitmask Flags (Byte 11)
constexpr uint8_t CADENCE_FLAG_STEADY            = (1 << 0); // Bit 0: 1 = Steady rhythmic cadence, 0 = Erratic/Unsteady
constexpr uint8_t CADENCE_FLAG_FIRST_STROKE      = (1 << 1); // Bit 1: 1 = First stroke or stroke following an idle pause
constexpr uint8_t CADENCE_FLAG_BENCH_MODE        = (1 << 2); // Bit 2: 1 = Bench profile active, 0 = Manikin profile
constexpr uint8_t CADENCE_FLAG_RECOIL_ESTIMATED  = (1 << 3); // Bit 3: 1 = recoil is an acceleration estimate (no force sensor)
constexpr uint8_t CADENCE_FLAG_SUB_PERIOD_BOUNCE = (1 << 4); // Bit 4: 1 = Sub-300ms period (!isPostPause && rawPeriodMs < 300ms)
constexpr uint8_t CADENCE_FLAG_WINDOW_CLAMPED    = (1 << 5); // Bit 5: 1 = Cycle integration window hit 66-sample ceiling clamp
constexpr uint8_t CADENCE_FLAG_HESITATION_ONSET  = (1 << 6); // Bit 6: 1 = Delayed downstroke peak (>120ms after onset trigger)
constexpr uint8_t CADENCE_FLAG_ENVELOPE_UNMASKED = (1 << 7); // Bit 7: 1 = Idle envelope unmask decay (0.960f) was active prior to onset

// Strict 1-byte packed network packet (Exactly 16 Bytes)
#pragma pack(push, 1)
struct CPRMetricsPacket {
    // Byte Offset 0: Packet Type Identifier
    uint8_t  packet_type;

    // Byte Offset 1: Recoil status (Live: 1=Full Recoil, 0=Leaning. Summary: Recoil compliance % 0..100)
    uint8_t  recoil_status;

    // Byte Offset 2..3: Cadence in compressions per minute (Live: current cpm. Summary: session mean cpm)
    uint16_t rate_cpm;

    // Byte Offset 4..5: Peak-to-peak compression depth in 0.1 mm (Live: current stroke. Summary: session mean depth)
    // Example: 540 = 54.0 mm = 5.40 cm
    uint16_t depth_tenths_mm;

    // Byte Offset 6: Cumulative Chest Compression Fraction percentage (0..100%)
    uint8_t  ccf_percent;

    // Byte Offset 7: Audio Coaching Trigger Code (0..6)
    uint8_t  audio_prompt_code;

    // Byte Offset 8: Stroke sequence index (Live) or total session compressions count (Summary)
    uint8_t  total_compressions;

    // Byte Offset 9..10: Elapsed session duration in seconds
    uint16_t session_elapsed_sec;

    // Byte Offset 11: Cadence Quality & Engine Bitmask Flags
    uint8_t  quality_flags;

    // Byte Offset 12..13: Stroke count without the 255 saturation of byte 8
    uint16_t stroke_count;

    // Byte Offset 14..15: Notification sequence number, set by BleManager for every sent packet
    uint16_t sequence;
};
#pragma pack(pop)

static_assert(sizeof(CPRMetricsPacket) == 16, "CPRMetricsPacket must be exactly 16 bytes");

// Type 6 Device Configuration Report Packet (Exactly 12 Bytes)
#pragma pack(push, 1)
struct CPRConfigPacket {
    uint8_t  packet_type;            // Byte 0: 6 (PKT_TYPE_CONFIG_REPORT)
    uint8_t  profile;                // Byte 1: 0 = MANIKIN, 1 = BENCH
    uint16_t depth_k_x100;           // Byte 2..3: Scaled K (e.g. 11.20 -> 1120)
    uint8_t  config_flags;           // Byte 4: Bit 0 = isBench, Bit 1 = hasCustomK, Bit 2 = useDualMpu, Bits 3..4 = sensPreset
    uint16_t practice_duration_sec;  // Byte 5..6: Active configured practice duration
    uint16_t default_duration_sec;   // Byte 7..8: Factory default duration (120s)
    uint8_t  protocol_version;       // Byte 9: Protocol version (1)
    uint16_t reserved;               // Byte 10: minStartThresholdG*1000, Byte 11: recoilArmFraction*100
};
#pragma pack(pop)

static_assert(sizeof(CPRConfigPacket) == 12, "CPRConfigPacket must be exactly 12 bytes");


/**
 * Session Summary Struct
 * Represents the final aggregated metrics across an entire completed practice session.
 */
struct CPRSessionSummary {
    float    avg_rate_cpm;
    float    avg_depth_cm;
    float    recoil_compliance_percent;
    float    final_ccf_percent;
    uint16_t total_compressions;
    uint16_t total_duration_sec;
    uint8_t  quality_flags;

    CPRSessionSummary(float rate = 0.0f, float depth = 0.0f, float recoil = 100.0f,
                      float ccf = 0.0f, uint16_t total = 0, uint16_t dur = 0,
                      uint8_t flags = CADENCE_FLAG_STEADY)
        : avg_rate_cpm(rate), avg_depth_cm(depth), recoil_compliance_percent(recoil),
          final_ccf_percent(ccf), total_compressions(total), total_duration_sec(dur),
          quality_flags(flags) {}

    CPRMetricsPacket toPacket(uint8_t packetType = PKT_TYPE_FINAL_SUMMARY) const {
        CPRMetricsPacket pkt;
        pkt.packet_type        = packetType;
        pkt.recoil_status      = (uint8_t)round(recoil_compliance_percent);
        pkt.rate_cpm           = (uint16_t)round(avg_rate_cpm);
        pkt.depth_tenths_mm    = (uint16_t)round(avg_depth_cm * 100.0f); // cm to 0.1 mm
        pkt.ccf_percent        = (uint8_t)round(final_ccf_percent);
        pkt.audio_prompt_code  = PROMPT_NONE;
        pkt.total_compressions = (uint8_t)(total_compressions > 255 ? 255 : total_compressions);
        pkt.session_elapsed_sec= total_duration_sec;
        pkt.quality_flags      = quality_flags;
        pkt.stroke_count       = total_compressions;
        pkt.sequence           = 0;
        return pkt;
    }
};


/**
 * High-Level Human-Readable Reading Helper
 */
struct CPRReading {
    float    rate_cpm;
    float    depth_cm;
    bool     recoil_complete;
    float    ccf_percentage;
    uint32_t elapsed_seconds;
    uint8_t  audio_prompt_code;
    uint16_t stroke_count;
    uint8_t  quality_flags;

    CPRReading(float rate = 0.0f, float depth = 0.0f, bool recoil = true,
               float ccf = 0.0f, uint32_t elapsed = 0, uint8_t prompt = PROMPT_NONE,
               uint16_t strokes = 0, uint8_t flags = CADENCE_FLAG_STEADY)
        : rate_cpm(rate), depth_cm(depth), recoil_complete(recoil),
          ccf_percentage(ccf), elapsed_seconds(elapsed), audio_prompt_code(prompt),
          stroke_count(strokes), quality_flags(flags) {}

    CPRMetricsPacket toPacket(uint8_t packetType = PKT_TYPE_REALTIME) const {
        CPRMetricsPacket pkt;
        pkt.packet_type        = packetType;
        pkt.recoil_status      = recoil_complete ? 1 : 0;
        pkt.rate_cpm           = (uint16_t)round(rate_cpm);
        pkt.depth_tenths_mm    = (uint16_t)round(depth_cm * 100.0f); // cm to 0.1 mm
        pkt.ccf_percent        = (uint8_t)round(ccf_percentage);
        pkt.audio_prompt_code  = audio_prompt_code;
        pkt.total_compressions = (uint8_t)(stroke_count > 255 ? 255 : stroke_count);
        pkt.session_elapsed_sec= (uint16_t)elapsed_seconds;
        pkt.quality_flags      = quality_flags;
        pkt.stroke_count       = stroke_count;
        pkt.sequence           = 0;
        return pkt;
    }

    static CPRReading fromPacket(const CPRMetricsPacket& pkt) {
        CPRReading r;
        r.rate_cpm          = (float)pkt.rate_cpm;
        r.depth_cm          = (float)pkt.depth_tenths_mm / 100.0f;
        r.recoil_complete   = (pkt.recoil_status == 1);
        r.ccf_percentage    = (float)pkt.ccf_percent;
        r.audio_prompt_code = pkt.audio_prompt_code;
        r.stroke_count      = pkt.stroke_count;
        r.elapsed_seconds   = (uint32_t)pkt.session_elapsed_sec;
        r.quality_flags     = pkt.quality_flags;
        return r;
    }

    String toDebugString() const {
        char buf[160];
        snprintf(buf, sizeof(buf),
            "Rate: %3.0f cpm | Depth: %4.2f cm | Recoil: %s | CCF: %3.0f%% | AudioCue: %d | Time: %3us | Flags: 0x%02X",
            rate_cpm, depth_cm, recoil_complete ? "OK" : "LEAN", ccf_percentage, audio_prompt_code, (unsigned)elapsed_seconds, quality_flags);
        return String(buf);
    }
};

/*
 ==============================================================================
 DART / FLUTTER DECODING SNIPPET (For Software & Mobile Developers)
 ==============================================================================
 
 Copy-paste this parser into your Flutter app's BLE listener:

 ```dart
 import 'dart:typed_data';

 class CPRMetrics {
   final int packetType;         // 1=Realtime, 2=Calibrating, 3=Calib Done, 4=Final Summary, 5=Error
   final bool recoilComplete;    // (Or recoil % if packetType == 4)
   final int recoilPercentage;   // 0..100%
   final int rateCpm;            // Current or average rate
   final double depthCm;         // Current or average depth (cm)
   final double depthMm;         // Current or average depth (mm)
   final int ccfPercent;         // Cumulative CCF %
   final int audioPromptCode;    // 0=None, 1=Push Harder, 2=Push Less, 3=Release Fully, 4=Speed Up, 5=Slow Down, 6=Good
   final int totalCompressions;  // Stroke count
   final int elapsedSeconds;     // Elapsed session duration
   final int qualityFlags;       // Bitmask: Bit 0 = Steady, Bit 1 = First/Post-Pause, Bit 2 = Bench Mode

   bool get isSteadyCadence => (qualityFlags & 0x01) != 0;
   bool get isFirstStrokeOrPostPause => (qualityFlags & 0x02) != 0;
   bool get isBenchMode => (qualityFlags & 0x04) != 0;

   CPRMetrics({
     required this.packetType,
     required this.recoilComplete,
     required this.recoilPercentage,
     required this.rateCpm,
     required this.depthCm,
     required this.depthMm,
     required this.ccfPercent,
     required this.audioPromptCode,
     required this.totalCompressions,
     required this.elapsedSeconds,
     required this.qualityFlags,
   });

   factory CPRMetrics.fromBytes(List<int> bytes) {
     if (bytes.length < 11) {
       throw ArgumentError("Expected at least 11 bytes, got ${bytes.length}");
     }
     final byteData = ByteData.sublistView(Uint8List.fromList(bytes));

     final type = byteData.getUint8(0);
     final recoilVal = byteData.getUint8(1);
     final rate = byteData.getUint16(2, Endian.little);
     final depthTenths = byteData.getUint16(4, Endian.little);
     final ccf = byteData.getUint8(6);
     final audioCue = byteData.getUint8(7);
     final totalCount = byteData.getUint8(8);
     final elapsed = byteData.getUint16(9, Endian.little);
     final flags = (bytes.length >= 12) ? byteData.getUint8(11) : 0x01; // Default to steady if 11 bytes received
     // Protocol v2 (16 bytes): bytes 12..13 = uint16 stroke count, bytes 14..15 = uint16 sequence
     final strokeCount16 = (bytes.length >= 16) ? byteData.getUint16(12, Endian.little) : totalCount;
     final sequence = (bytes.length >= 16) ? byteData.getUint16(14, Endian.little) : null;

     return CPRMetrics(
       packetType: type,
       recoilComplete: recoilVal == 1,
       recoilPercentage: recoilVal,
       rateCpm: rate,
       depthCm: depthTenths / 100.0,
       depthMm: depthTenths / 10.0,
       ccfPercent: ccf,
       audioPromptCode: audioCue,
       totalCompressions: strokeCount16,
       elapsedSeconds: elapsed,
       qualityFlags: flags,
     );
   }
 }

 // Characteristic UUIDs:
 // static const String serviceUuid     = "6e400001-b5a3-f393-e0a9-e50e24dcca9e";
 // static const String metricsCharUuid = "6e400002-b5a3-f393-e0a9-e50e24dcca9e";
 // static const String commandCharUuid = "6e400003-b5a3-f393-e0a9-e50e24dcca9e";

 // Mobile Audio Cue Dispatcher Example (using flutter_tts):
 // void handleAudioPrompt(int cueCode) {
 //   switch (cueCode) {
 //     case 1: tts.speak("Push harder"); break;
 //     case 2: tts.speak("Push shallower"); break;
 //     case 3: tts.speak("Release chest completely"); break;
 //     case 4: tts.speak("Speed up"); break;
 //     case 5: tts.speak("Slow down"); break;
 //     case 6: tts.speak("Good compressions"); break;
 //     case 7: tts.speak("Maintain a steady rhythm"); break;
 //   }
 // }
 ```
 ==============================================================================
*/

#endif // BLE_READINGS_H
