Marni3/CPReady/CPReady_Program/src/simulation.cpp

/**
 * CPReady simulation firmware.
 *
 * Build target: PlatformIO environment `simulation` (`CPREADY_SIMULATION`).
 *
 * Exposes the same GATT service, the same 16-byte telemetry packet and the same
 * text commands as the sensor build, but replaces the MPU-6050 pair with the
 * synthetic signal from SyntheticVest. That signal is processed by the
 * production CompressionTracker, so rate, depth, recoil, CCF, quality flags,
 * audio cue codes and the final summary all come from the same logic the vest
 * runs.
 *
 * The sensor build remains src/main.cpp; this file is compiled only for the
 * simulation environment.
 */

#ifdef CPREADY_SIMULATION

#include <Arduino.h>
#include <Preferences.h>

#include "CPRTypes.h"
#include "CPReadyConfig.h"
#include "BLEReadings.h"
#include "BleManager.h"
#include "CompressionTracker.h"
#include "SimulationConfig.h"
#include "SyntheticVest.h"
#include "TelemetryStream.h"

// --- Subsystems -------------------------------------------------------------

static BleManager         simBle;
static CompressionTracker simTracker;
static Preferences        simPrefs;
static SyntheticVest      simVest;
static TelemetryStream    simTelemetry;

// --- Session state ----------------------------------------------------------

static DeviceState simState = DeviceState::STANDBY;

static uint32_t simCalibrationStartMs    = 0;
static uint32_t simCalibrationProgressMs = 0;
static uint32_t simLastCalibrationMicros = 0;

static uint32_t simLastNotifyMs     = 0;
static uint32_t simLastSampleMicros = 0;
static float    simFilteredNetG     = 0.0f;   // Same low-pass as SensorManager, for detection

static uint32_t simPracticeDurationSec = CPReadyConfig::DEFAULT_PRACTICE_DURATION_SEC;
static bool     simUseDualMpu          = CPReadyConfig::DEFAULT_USE_DUAL_MPU;

// --- Calibration window -----------------------------------------------------

static uint16_t simCalibrationSamples = 0;
static float    simCalibrationMinG    = 0.0f;
static float    simCalibrationMaxG    = 0.0f;

// Injected motion makes the baseline fail the same spread check the device
// applies, so the error and retry path can be exercised without sensors.
static bool simCalibrationMotion = false;

// --- Diagnostics ------------------------------------------------------------

static uint8_t     simForcedCue      = PROMPT_NONE;
static uint8_t     simLastLoggedCue  = PROMPT_NONE;
static int8_t      simLastPhase      = -1;
static String      simSerialLine     = "";

// True while the running K is the temporary default of a 15 s calibration trial.
static bool        simKTrialOverride = false;

// --- Test mode ----------------------------------------------------------------

// Test mode runs specific input values through the production tracker so
// classification, color, and audio feedback can be observed. Each value
// appears three times per testing session.
static bool        simTestMode       = false;
static uint8_t     simTestPhaseIndex = 0;
static const SimConfig::Phase* simTestPhases = SimConfig::TEST_PHASES;
static uint8_t     simTestPhaseCount = SimConfig::TEST_PHASE_COUNT;

static void simBeginKTrialOverride() {
    simTracker.resetCalibrationToDefault();   // RAM only
    simKTrialOverride = true;
    Serial.printf("[CALIB] Trial K override: using default %.2f (saved K kept)\n", simTracker.getDepthK());
}

static void simRestoreSavedK() {
    const float km = simPrefs.getFloat("k_manikin", CPReadyConfig::DEPTH_CALIBRATION_K);
    const float kb = simPrefs.getFloat("k_bench", CPReadyConfig::BENCH_DEPTH_CALIBRATION_K);
    if (km >= CPReadyConfig::DEPTH_K_MIN && km <= CPReadyConfig::DEPTH_K_MAX) simTracker.setManikinK(km);
    if (kb >= CPReadyConfig::DEPTH_K_MIN && kb <= CPReadyConfig::DEPTH_K_MAX) simTracker.setBenchK(kb);
    simTracker.setProfile(simTracker.getProfile());
    simKTrialOverride = false;
    Serial.printf("[CALIB] Saved K restored: %.2f\n", simTracker.getDepthK());
}

// ---------------------------------------------------------------------------
// Helpers
// ---------------------------------------------------------------------------

static const char* stateName(DeviceState state) {
    switch (state) {
        case DeviceState::STANDBY:          return "STANDBY";
        case DeviceState::CALIBRATING:      return "CALIBRATING";
        case DeviceState::ACTIVE_SESSION:   return "ACTIVE_SESSION";
        case DeviceState::SESSION_PAUSED:   return "SESSION_PAUSED";
        case DeviceState::FAULT_ERROR:      return "FAULT_ERROR";
        case DeviceState::CALIBRATED_READY: return "CALIBRATED_READY";
        default:                            return "UNKNOWN";
    }
}

static const char* profileName(CPReadyConfig::KinematicProfile profile) {
    return profile == CPReadyConfig::KinematicProfile::BENCH_TEST
        ? "BENCH_TEST"
        : "MANIKIN_STANDARD";
}

static const char* cueName(uint8_t code) {
    switch (code) {
        case PROMPT_PUSH_HARDER:   return "push harder";
        case PROMPT_PUSH_LESS:     return "push shallower";
        case PROMPT_RELEASE_FULLY: return "release chest completely";
        case PROMPT_SPEED_UP:      return "speed up";
        case PROMPT_SLOW_DOWN:     return "slow down";
        case PROMPT_GOOD_JOB:      return "good compressions";
        default:                   return "none";
    }
}

/**
 * Calibration and progress packets follow the sensor build's layout: recoil
 * reported as complete, steady cadence flag set, no audio cue, elapsed window.
 */
static CPRMetricsPacket makeCalibrationPacket(uint8_t packetType, uint16_t elapsedSec) {
    CPRMetricsPacket pkt{};
    pkt.packet_type        = packetType;
    pkt.recoil_status      = 1;
    pkt.audio_prompt_code  = PROMPT_NONE;
    pkt.session_elapsed_sec = elapsedSec;
    pkt.quality_flags      = CADENCE_FLAG_STEADY;
    return pkt;
}

/** Error packets carry an optional reason code in audio_prompt_code (Byte 7), matching main.cpp. */
static CPRMetricsPacket makeErrorPacket(uint8_t reason = ERR_NONE) {
    CPRMetricsPacket pkt{};
    pkt.packet_type       = PKT_TYPE_ERROR;
    pkt.audio_prompt_code = reason;
    return pkt;
}

static CPRConfigPacket makeConfigPacket(uint8_t profile, float depthK, uint32_t autoStopDurationSec) {
    bool isBench = (profile == 1);
    float defaultK = isBench ? CPReadyConfig::BENCH_DEPTH_CALIBRATION_K : CPReadyConfig::DEPTH_CALIBRATION_K;
    bool hasCustomK = fabsf(depthK - defaultK) > 0.05f;
    uint8_t flags = 0;
    if (isBench) flags |= 0x01;
    if (hasCustomK) flags |= 0x02;
    if (simUseDualMpu) flags |= 0x04;
    flags |= (uint8_t)((simTracker.getSensitivityPresetCode() & 0x03) << 3);

    uint8_t trigByte = (uint8_t)lroundf(simTracker.getMinStartThresholdG() * 1000.0f);
    uint8_t armByte  = (uint8_t)lroundf(simTracker.getRecoilArmFraction() * 100.0f);

    CPRConfigPacket cfgPkt{};
    cfgPkt.packet_type           = PKT_TYPE_CONFIG_REPORT;
    cfgPkt.profile               = profile;
    cfgPkt.depth_k_x100          = (uint16_t)roundf(depthK * 100.0f);
    cfgPkt.config_flags          = flags;
    cfgPkt.practice_duration_sec = (uint16_t)autoStopDurationSec;
    cfgPkt.default_duration_sec  = (uint16_t)CPReadyConfig::DEFAULT_PRACTICE_DURATION_SEC;
    cfgPkt.protocol_version      = 1;
    cfgPkt.reserved              = (uint16_t)trigByte | ((uint16_t)armByte << 8);
    return cfgPkt;
}

// ---------------------------------------------------------------------------
// Flow
// ---------------------------------------------------------------------------

/**
 * Opens the 2 s baseline window.
 *
 * The window counts 100 Hz samples and tracks the peak-to-peak spread of the
 * net signal, matching the sample-count and net-spread limits SensorManager
 * checks. A synthetic stroke source has no static gravity offset to remove, so
 * this stage gates the session rather than altering the waveform; the depth
 * reported later is a peak-to-peak quantity and a constant offset would cancel.
 */
static void beginSimCalibration(uint32_t now) {
    // As in main.cpp: a new calibration drops the previous summary.
    simTracker.reset();
    simCalibrationStartMs    = now;
    simCalibrationProgressMs = now;
    simLastCalibrationMicros = micros();
    simCalibrationSamples    = 0;
    simCalibrationMinG       = 999.0f;
    simCalibrationMaxG       = -999.0f;

    simState = DeviceState::CALIBRATING;

    simBle.sendPacket(makeCalibrationPacket(PKT_TYPE_CALIB_PROGRESS, 0));
    Serial.printf("[FLOW] Calibration started: %u ms baseline window.\n",
                  (unsigned)CPReadyConfig::CALIBRATION_DURATION_MS);
}

/**
 * Starts an active session and restarts the stroke scenario.
 *
 * The simulated strokes have a fixed physical depth, so a retuned K shows up as a
 * proportional change in the reported depth, exactly as on the vest.
 */
static void startSimSession(uint32_t now) {
    const bool steadyTrial =
        simPracticeDurationSec > 0 &&
        simPracticeDurationSec <= SimConfig::STEADY_TRIAL_MAX_SEC;

    if (simKTrialOverride && simPracticeDurationSec != CPReadyConfig::CALIBRATION_RUN_DURATION_SEC) {
        simRestoreSavedK();
    }
    simTracker.startSession(now);

    if (simTestMode) {
        // Test mode: run through all test phases. Duration covers every phase.
        uint32_t totalSec = 0;
        for (uint8_t i = 0; i < simTestPhaseCount; i++) {
            totalSec += simTestPhases[i].durationMs / 1000;
        }
        simPracticeDurationSec = totalSec;
        simVest.begin(now, false, simTestPhases, simTestPhaseCount);
        Serial.printf("[FLOW] Test session started: %u phases | %u s\n",
                      (unsigned)simTestPhaseCount, (unsigned)simPracticeDurationSec);
    } else {
        simVest.begin(now, steadyTrial);
        Serial.printf("[FLOW] Session started: %s | depth K %.2f | duration %u s\n",
                      steadyTrial ? "steady depth trial" : "cue scenario",
                      simTracker.getDepthK(), (unsigned)simPracticeDurationSec);
    }

    simTelemetry.resetCounters();

    simLastNotifyMs     = now;
    simLastSampleMicros = micros();
    simFilteredNetG     = 0.0f;
    simLastPhase        = -1;
    simLastLoggedCue    = PROMPT_NONE;
    simState            = DeviceState::ACTIVE_SESSION;
}

/** Finalises the tracker and publishes the session summary. */
static void endSimSession(uint32_t now, const char* reason) {
    simTelemetry.flush();
    simTelemetry.setEnabled(false);
    CPRSessionSummary summary = simTracker.finalizeSession(now);
    CPRMetricsPacket pkt = summary.toPacket(PKT_TYPE_FINAL_SUMMARY);

    simBle.sendPacket(pkt);
    simState     = DeviceState::STANDBY;
    simLastPhase = -1;
    simPracticeDurationSec = CPReadyConfig::DEFAULT_PRACTICE_DURATION_SEC;

    Serial.printf("[FINAL TX] %s | Rate %.0f cpm | Depth %.2f cm | Recoil %.0f%% | "
                  "CCF %.0f%% | Strokes %u | Time %u s\n",
                  reason,
                  summary.avg_rate_cpm,
                  summary.avg_depth_cm,
                  summary.recoil_compliance_percent,
                  summary.final_ccf_percent,
                  (unsigned)summary.total_compressions,
                  (unsigned)summary.total_duration_sec);
}

// ---------------------------------------------------------------------------
// Command handling
// ---------------------------------------------------------------------------

/** Configuration changes are refused while a calibration or session runs (as in main.cpp). */
static bool simRejectConfigChange(const String& message) {
    if (simState == DeviceState::STANDBY ||
        simState == DeviceState::CALIBRATED_READY ||
        simState == DeviceState::FAULT_ERROR) {
        return false;
    }
    Serial.println("[FLOW] " + message + " rejected: calibration or session in progress.");
    simBle.sendPacket(makeErrorPacket(ERR_WRONG_STATE));
    return true;
}

static void handleBleCommand(String message) {
    message.trim();
    message.toUpperCase();
    Serial.println("[BLE CMD] Received: " + message);

    if (message == "CALIBRATE") {
        if (simState == DeviceState::ACTIVE_SESSION || simState == DeviceState::SESSION_PAUSED) {
            Serial.println("[FLOW] Calibrate rejected: active session running.");
            simBle.sendPacket(makeErrorPacket(ERR_WRONG_STATE));
            return;
        }
        beginSimCalibration(millis());
    }
    else if (message == "START") {
        if (simState == DeviceState::CALIBRATED_READY) {
            startSimSession(millis());
        }
        else if (simState == DeviceState::ACTIVE_SESSION) {
            Serial.println("[FLOW] Start received while already running; ignored.");
        }
        else {
            Serial.println("[FLOW] Start rejected: send CALIBRATE and wait for the baseline first.");
            simBle.sendPacket(makeErrorPacket(ERR_WRONG_STATE));
        }
    }
    else if (message == "STOP") {
        if (simState == DeviceState::ACTIVE_SESSION ||
            simState == DeviceState::SESSION_PAUSED) {
            endSimSession(millis(), "stop command");
        }
        else if (simState == DeviceState::CALIBRATING ||
                 simState == DeviceState::CALIBRATED_READY) {
            Serial.println("[FLOW] Stop before the session started; calibration cancelled.");
            simPracticeDurationSec = CPReadyConfig::DEFAULT_PRACTICE_DURATION_SEC;
            if (simKTrialOverride) simRestoreSavedK();
            simState = DeviceState::STANDBY;
        }
        else {
            Serial.println("[FLOW] Stop while idle; ignored (GET_RESULTS re-sends the summary).");
            simPracticeDurationSec = CPReadyConfig::DEFAULT_PRACTICE_DURATION_SEC;
            if (simKTrialOverride) simRestoreSavedK();
        }
    }
    else if (message == "GET_RESULTS") {
        simBle.sendPacket(simTracker.getLastSummary().toPacket(PKT_TYPE_FINAL_SUMMARY));
        Serial.println("[FLOW] Summary resent.");
    }
    else if (message == "TELEM:1") {
        simTelemetry.setEnabled(true);
    }
    else if (message == "TELEM:0") {
        simTelemetry.setEnabled(false);
    }
    else if (message == "PAUSE") {
        if (simState == DeviceState::ACTIVE_SESSION) {
            simTracker.pauseSession(millis());
            simState = DeviceState::SESSION_PAUSED;
            Serial.println("[FLOW] Session paused.");
        }
        else if (simState != DeviceState::SESSION_PAUSED) {
            simBle.sendPacket(makeErrorPacket(ERR_WRONG_STATE));
        }
    }
    else if (message == "RESUME") {
        if (simState == DeviceState::SESSION_PAUSED) {
            simTracker.resumeSession(millis());
            simState = DeviceState::ACTIVE_SESSION;
            Serial.println("[FLOW] Session resumed.");
        }
        else if (simState != DeviceState::ACTIVE_SESSION) {
            simBle.sendPacket(makeErrorPacket(ERR_WRONG_STATE));
        }
    }
    else if (message.startsWith("SET_TIME:")) {
        if (simRejectConfigChange(message)) return;
        const String digits = message.substring(9);
        bool numeric = digits.length() > 0 && digits.length() <= 5;
        for (unsigned int i = 0; numeric && i < digits.length(); i++) {
            numeric = isDigit(digits[i]);
        }
        const long seconds = numeric ? digits.toInt() : -1;
        if (seconds >= 0 && seconds <= 3600) {
            simPracticeDurationSec = (uint32_t)seconds;
            if (simPracticeDurationSec == CPReadyConfig::CALIBRATION_RUN_DURATION_SEC) {
                simBeginKTrialOverride();
            }
            Serial.printf("[CONFIG] Session duration set to %u s (0 = manual stop).\n", (unsigned)simPracticeDurationSec);
        }
    }
    else if (message == "RESET_K" || message == "CALIBRATE_RESET") {
        if (simRejectConfigChange(message)) return;
        simBeginKTrialOverride();   // RAM only; no Type 3 packet (see main.cpp)
    }
    else if (message.startsWith("SET_MPU:")) {
        if (simRejectConfigChange(message)) return;
        int mpuCount = message.substring(8).toInt();
        simUseDualMpu = (mpuCount >= 2);
        simPrefs.putBool("dual_mpu", simUseDualMpu);
        Serial.printf("[CONFIG] Simulated sensor mode set to %s.\n",
                      simUseDualMpu ? "2-MPU (Differential)" : "1-MPU (Chest Only)");
    }
    else if (message.startsWith("SET_I2C:")) {
        if (simRejectConfigChange(message)) return;
        uint32_t speed = message.substring(8).toInt();
        uint32_t hz = (speed >= 400) ? 400000 : 100000;
        simPrefs.putUInt("i2c_speed", hz);
        Serial.printf("[CONFIG] Simulated I2C speed set to %lu Hz. Restarting...\n", (unsigned long)hz);
        delay(300);
        ESP.restart();
    }
    else if (message.startsWith("SET_SENS:")) {
        if (simRejectConfigChange(message)) return;
        String mode = message.substring(9);
        uint8_t preset = 0;
        if (mode == "HIGH") preset = 1;
        else if (mode == "STRICT") preset = 2;
        simTracker.applySensitivityPreset(preset);
        simPrefs.putFloat("trig_g", simTracker.getMinStartThresholdG());
        simPrefs.putFloat("arm_frac", simTracker.getRecoilArmFraction());
        simPrefs.putFloat("min_d_cm", simTracker.getMinStrokeDepthCm());
        Serial.printf("[CONFIG] Sensitivity preset %s applied.\n", mode.c_str());
    }
    else if (message.startsWith("SET_TRIG:")) {
        if (simRejectConfigChange(message)) return;
        float g = message.substring(9).toFloat();
        if (g >= 0.03f && g <= 0.60f) {
            simTracker.setMinStartThresholdG(g);
            simPrefs.putFloat("trig_g", simTracker.getMinStartThresholdG());
        }
    }
    else if (message.startsWith("SET_ARM:")) {
        if (simRejectConfigChange(message)) return;
        float frac = message.substring(8).toFloat();
        if (frac >= 0.05f && frac <= 0.50f) {
            simTracker.setRecoilArmFraction(frac);
            simPrefs.putFloat("arm_frac", simTracker.getRecoilArmFraction());
        }
    }
    else if (message.startsWith("SET_MIN_D:")) {
        if (simRejectConfigChange(message)) return;
        float cm = message.substring(10).toFloat();
        if (cm >= 0.05f && cm <= 2.50f) {
            simTracker.setMinStrokeDepthCm(cm);
            simPrefs.putFloat("min_d_cm", simTracker.getMinStrokeDepthCm());
        }
    }
    else if (message.startsWith("SET_K:")) {
        if (simRejectConfigChange(message)) return;
        const float k = message.substring(6).toFloat();
        if (k >= CPReadyConfig::DEPTH_K_MIN && k <= CPReadyConfig::DEPTH_K_MAX) {
            simTracker.setDepthK(k);
            simPrefs.putFloat(simTracker.getProfile() == CPReadyConfig::KinematicProfile::BENCH_TEST
                                  ? "k_bench" : "k_manikin", k);
            Serial.printf("[NVS] Depth scalar K set to %.2f.\n", k);
        }
    }
    else if (message == "SET_PROFILE:BENCH") {
        if (simRejectConfigChange(message)) return;
        simTracker.setProfile(CPReadyConfig::KinematicProfile::BENCH_TEST);
        simPrefs.putUChar("profile", (uint8_t)CPReadyConfig::KinematicProfile::BENCH_TEST);
        Serial.printf("[NVS] Profile BENCH_TEST applied (K %.2f).\n", simTracker.getDepthK());
    }
    else if (message == "SET_PROFILE:MANIKIN") {
        if (simRejectConfigChange(message)) return;
        simTracker.setProfile(CPReadyConfig::KinematicProfile::MANIKIN_STANDARD);
        simPrefs.putUChar("profile", (uint8_t)CPReadyConfig::KinematicProfile::MANIKIN_STANDARD);
        Serial.printf("[NVS] Profile MANIKIN_STANDARD applied (K %.2f).\n", simTracker.getDepthK());
    }
    else if (message.startsWith("CALIBRATE_TARGET:")) {
        if (simRejectConfigChange(message)) return;
        const float targetCm = message.substring(17).toFloat();
        const float previousK = simTracker.getDepthK();
        float newK = 0.0f;
        uint8_t errReason = ERR_NO_TRIAL_DATA;

        if (simTracker.calibrateFromLastSummary(targetCm, newK, &errReason)) {
            if (simTracker.getProfile() == CPReadyConfig::KinematicProfile::BENCH_TEST) {
                simPrefs.putFloat("k_bench", newK);
            } else {
                simPrefs.putFloat("k_manikin", newK);
            }
            simKTrialOverride = false;
            Serial.printf("[CALIB] Target %.2f cm scales K %.2f -> %.2f.\n",
                          targetCm, previousK, newK);
            simBle.sendPacket(makeCalibrationPacket(PKT_TYPE_CALIB_SUCCESS, 0));
        }
        else {
            Serial.printf("[CALIB] Target %.2f cm rejected (reason=%u).\n",
                          targetCm, (unsigned)errReason);
            simBle.sendPacket(makeErrorPacket(errReason));
        }
    }
    else if (message == "RESET_CONFIG") {
        if (simRejectConfigChange(message)) return;
        simPrefs.clear();
        simPrefs.putUChar("depth_model", CPReadyConfig::DEPTH_MODEL_VERSION);
        simTracker.setManikinK(CPReadyConfig::DEPTH_CALIBRATION_K);
        simTracker.setBenchK(CPReadyConfig::BENCH_DEPTH_CALIBRATION_K);
        simTracker.setProfile(CPReadyConfig::KinematicProfile::MANIKIN_STANDARD);
        simTracker.applySensitivityPreset(0);
        simUseDualMpu = CPReadyConfig::DEFAULT_USE_DUAL_MPU;
        simPracticeDurationSec = CPReadyConfig::DEFAULT_PRACTICE_DURATION_SEC;
        simKTrialOverride = false;
        Serial.println("[NVS] Simulation configuration cleared.");
    }
    else if (message == "GET_CONFIG") {
        CPRConfigPacket cfgPkt = makeConfigPacket(
            (uint8_t)simTracker.getProfile(),
            simTracker.getDepthK(),
            simPracticeDurationSec
        );
        simBle.sendPacket(cfgPkt);
        Serial.printf("[CONFIG] Profile: %s | Depth K: %.2f | Start: %.2fg | Recoil: %.2fg | Duration: %u s\n",
                      profileName(simTracker.getProfile()),
                      simTracker.getDepthK(),
                      simTracker.getCompressionStartThresholdG(),
                      simTracker.getRecoilThresholdG(),
                      (unsigned)simPracticeDurationSec);
    }
    else {
        Serial.println("[BLE CMD] Unhandled command: " + message);
    }
}

// ---------------------------------------------------------------------------
// Serial console
// ---------------------------------------------------------------------------

static void printSimStatus() {
    const CPRReading& reading = simTracker.getReading();

    Serial.printf("[SIM] State %s | Profile %s | K %.2f | Duration %u s\n",
                  stateName(simState),
                  profileName(simTracker.getProfile()),
                  simTracker.getDepthK(),
                  (unsigned)simPracticeDurationSec);
    Serial.printf("[SIM] Elapsed %u s | Strokes %u | Rate %.0f cpm | Depth %.2f cm | Cue %u\n",
                  (unsigned)reading.elapsed_seconds,
                  (unsigned)reading.stroke_count,
                  reading.rate_cpm,
                  reading.depth_cm,
                  (unsigned)reading.audio_prompt_code);
    Serial.printf("[SIM] Calibration motion injection %s | Forced cue %u\n",
                  simCalibrationMotion ? "ON" : "OFF",
                  (unsigned)simForcedCue);
}

static void handleSerialCommand(String line) {
    line.trim();
    line.toUpperCase();

    if (!line.startsWith("SIM:")) {
        Serial.println("[SIM] Unrecognised input: " + line);
        return;
    }

    if (line == "SIM:STATUS") {
        printSimStatus();
    }
    else if (line == "SIM:CALIB") {
        beginSimCalibration(millis());
    }
    else if (line == "SIM:START") {
        if (simState == DeviceState::CALIBRATED_READY) {
            startSimSession(millis());
        }
        else {
            Serial.println("[SIM] START needs a completed baseline calibration.");
        }
    }
    else if (line == "SIM:STOP") {
        if (simState == DeviceState::ACTIVE_SESSION ||
            simState == DeviceState::SESSION_PAUSED) {
            endSimSession(millis(), "console stop");
        }
        else {
            Serial.println("[SIM] No active session to stop.");
        }
    }
    else if (line == "SIM:CALIB:FAIL") {
        simCalibrationMotion = true;
        Serial.println("[SIM] Calibration motion injection enabled; baselines fail until SIM:CALIB:OK.");
    }
    else if (line == "SIM:CALIB:OK") {
        simCalibrationMotion = false;
        Serial.println("[SIM] Calibration motion injection disabled.");
    }
    else if (line.startsWith("SIM:CUE:")) {
        const int code = line.substring(8).toInt();
        if (code >= 1 && code <= 6) {
            simForcedCue = (uint8_t)code;
            Serial.printf("[SIM] Cue %d (%s) queued for the next realtime packet.\n",
                          code, cueName((uint8_t)code));
        }
        else {
            Serial.println("[SIM] Cue code must be 1..6.");
        }
    }
    else if (line == "SIM:TEST:DEPTH") {
        simTestMode = true;
        simTestPhases = &SimConfig::TEST_PHASES[0];
        simTestPhaseCount = 15;
        simTestPhaseIndex = 0;
        Serial.println("[TEST] Depth test mode: 4.99 / 5.00 / 5.50 / 6.00 / 6.01 cm (3x each). Send SIM:START.");
    }
    else if (line == "SIM:TEST:RATE") {
        simTestMode = true;
        simTestPhases = &SimConfig::TEST_PHASES[15];
        simTestPhaseCount = 15;
        simTestPhaseIndex = 0;
        Serial.println("[TEST] Rate test mode: 99 / 100 / 110 / 120 / 121 cpm (3x each). Send SIM:START.");
    }
    else if (line == "SIM:TEST:RECOIL") {
        simTestMode = true;
        simTestPhases = &SimConfig::TEST_PHASES[30];
        simTestPhaseCount = 6;
        simTestPhaseIndex = 0;
        Serial.println("[TEST] Recoil test mode: 89.9% / 90% (3x each). Send SIM:START.");
    }
    else if (line == "SIM:TEST:CCF") {
        simTestMode = true;
        simTestPhases = &SimConfig::TEST_PHASES[36];
        simTestPhaseCount = 6;
        simTestPhaseIndex = 0;
        Serial.println("[TEST] CCF test mode: 59.9% / 60% (3x each). Send SIM:START.");
    }
    else if (line == "SIM:TEST:ALL") {
        simTestMode = true;
        simTestPhases = SimConfig::TEST_PHASES;
        simTestPhaseCount = SimConfig::TEST_PHASE_COUNT;
        simTestPhaseIndex = 0;
        Serial.println("[TEST] All test mode: depth / rate / recoil / CCF (3x each). Send SIM:START.");
    }
    else if (line == "SIM:TEST:INVALID") {
        simCalibrationMotion = true;
        Serial.println("[TEST] Invalid sensor mode: calibration motion injection enabled. Send SIM:CALIB to trigger failure.");
    }
    else if (line == "SIM:TEST:STOP") {
        simTestMode = false;
        simTestPhases = SimConfig::TEST_PHASES;
        simTestPhaseCount = SimConfig::TEST_PHASE_COUNT;
        simTestPhaseIndex = 0;
        Serial.println("[TEST] Test mode disabled.");
    }
    else {
        Serial.println("[SIM] Commands: SIM:STATUS | SIM:CALIB | SIM:START | SIM:STOP | "
                       "SIM:CUE:<1-6> | SIM:CALIB:FAIL | SIM:CALIB:OK | "
                       "SIM:TEST:DEPTH | SIM:TEST:RATE | SIM:TEST:RECOIL | "
                       "SIM:TEST:CCF | SIM:TEST:ALL | SIM:TEST:INVALID | SIM:TEST:STOP");
    }
}

static void pollSerial() {
    while (Serial.available() > 0) {
        const char c = (char)Serial.read();

        if (c == '\n' || c == '\r') {
            if (simSerialLine.length() > 0) {
                handleSerialCommand(simSerialLine);
                simSerialLine = "";
            }
        }
        else if (simSerialLine.length() < 48) {
            simSerialLine += c;
        }
    }
}

// ---------------------------------------------------------------------------
// State updates
// ---------------------------------------------------------------------------

static void updateCalibration(uint32_t now, uint32_t nowMicros) {
    if (nowMicros - simLastCalibrationMicros >= SimConfig::SAMPLE_INTERVAL_MICROS) {
        simLastCalibrationMicros = nowMicros;

        // A still vest reads zero net acceleration. Injected motion alternates
        // above and below zero, which exceeds the permitted net spread.
        const float sampleG = simCalibrationMotion
            ? ((simCalibrationSamples % 2u) ? 0.20f : -0.20f)
            : 0.0f;

        if (sampleG < simCalibrationMinG) simCalibrationMinG = sampleG;
        if (sampleG > simCalibrationMaxG) simCalibrationMaxG = sampleG;
        simCalibrationSamples++;
    }

    if (now - simCalibrationProgressMs >= CPReadyConfig::CALIBRATION_PROGRESS_INTERVAL_MS) {
        simCalibrationProgressMs = now;
        const uint16_t elapsedSec = (uint16_t)((now - simCalibrationStartMs) / 1000);
        simBle.sendPacket(makeCalibrationPacket(PKT_TYPE_CALIB_PROGRESS, elapsedSec));
        Serial.printf("[CALIB TX] Progress %u s.\n", (unsigned)elapsedSec);
    }

    if (now - simCalibrationStartMs < CPReadyConfig::CALIBRATION_DURATION_MS) return;

    const bool enoughSamples = simCalibrationSamples >= CPReadyConfig::CALIBRATION_MIN_SAMPLE_COUNT;
    const float spreadG = simCalibrationMaxG - simCalibrationMinG;
    const bool stable = spreadG <= CPReadyConfig::CALIBRATION_MAX_NET_SPREAD_G;

    if (enoughSamples && stable) {
        simState = DeviceState::CALIBRATED_READY;
        simBle.sendPacket(makeCalibrationPacket(PKT_TYPE_CALIB_SUCCESS, 0));
        Serial.printf("[FLOW] Calibration complete: %u samples, net spread %.2f g. Ready to start.\n",
                      (unsigned)simCalibrationSamples, spreadG);
    }
    else {
        simState = DeviceState::STANDBY;
        uint8_t reason = (simCalibrationSamples < CPReadyConfig::CALIBRATION_MIN_SAMPLE_COUNT)
            ? ERR_LOW_SAMPLE_COUNT
            : ERR_MOTION_UNSTABLE;
        simBle.sendPacket(makeErrorPacket(reason));
        Serial.printf("[CALIB FAIL] Samples %u (min %u), net spread %.2f g (max %.2f g).\n",
                      (unsigned)simCalibrationSamples,
                      (unsigned)CPReadyConfig::CALIBRATION_MIN_SAMPLE_COUNT,
                      spreadG,
                      CPReadyConfig::CALIBRATION_MAX_NET_SPREAD_G);
    }
}

static void updateActiveSession(uint32_t now, uint32_t nowMicros) {
    if (nowMicros - simLastSampleMicros < SimConfig::SAMPLE_INTERVAL_MICROS) return;
    simLastSampleMicros = nowMicros;

    const uint8_t phaseIndex = simVest.phaseIndexAt(now);
    if ((int8_t)phaseIndex != simLastPhase) {
        simLastPhase = (int8_t)phaseIndex;
        if (simTestMode) {
            const SimConfig::Phase& phase = simTestPhases[phaseIndex];
            Serial.printf("[TEST] Phase %u/%u: %s (%u cpm, %.1f cm, recoil %.0f%%)\n",
                          (unsigned)(phaseIndex + 1),
                          (unsigned)simTestPhaseCount,
                          phase.label,
                          (unsigned)phase.rateCpm,
                          phase.depthCm,
                          (double)(phase.recoilFraction * 100.0f));
        } else {
            const SimConfig::Phase& phase = SimConfig::PHASES[phaseIndex];
            Serial.printf("[SIM] Phase %u/%u: %s (%u cpm, %.1f cm)\n",
                          (unsigned)(phaseIndex + 1),
                          (unsigned)SimConfig::PHASE_COUNT,
                          phase.label,
                          (unsigned)phase.rateCpm,
                          phase.depthCm);
        }
    }

    const float rawNetG = simVest.netAccelAt(now);
    const float alpha = CPReadyConfig::LOWPASS_FILTER_ALPHA;
    simFilteredNetG = alpha * rawNetG + (1.0f - alpha) * simFilteredNetG;
    const bool strokeCompleted = simTracker.processSample(simFilteredNetG, rawNetG, now);

    // Synthetic raw frame: chest Z carries the inverse of the net signal and the
    // base stays at zero, so an offline replay computes the same net value with
    // the production -(chest - base) convention. The other axes stay at zero.
    TelemetryFrames::SensorRawSample raw{};
    raw.t_us = nowMicros;
    raw.chest_mg[2] = (int16_t)lroundf(-rawNetG * 1000.0f);
    simTelemetry.addSample(raw, simTracker.getReading().stroke_count, simState,
                           simTracker.getLastUnclampedDepthMm());

    if (!strokeCompleted && (now - simLastNotifyMs < CPReadyConfig::BLE_NOTIFY_INTERVAL_MS)) {
        return;
    }
    simLastNotifyMs = now;

    const CPRReading& reading = simTracker.getReading();
    CPRMetricsPacket pkt = reading.toPacket(PKT_TYPE_REALTIME);

    // A queued console cue replaces the engine's decision for one packet, which
    // allows each speaker cue to be checked without waiting for the scenario.
    if (simForcedCue != PROMPT_NONE) {
        pkt.audio_prompt_code = simForcedCue;
        simForcedCue = PROMPT_NONE;
    }

    simBle.sendPacket(pkt);

    if (strokeCompleted) {
        Serial.println("[STROKE] " + reading.toDebugString());
    }
    // As in main.cpp, a cue is announced in exactly one packet.
    simTracker.clearAudioPrompt();

    if (pkt.audio_prompt_code != PROMPT_NONE &&
        pkt.audio_prompt_code != simLastLoggedCue) {
        Serial.printf("[CUE] %s (%u) at %u s\n",
                      cueName(pkt.audio_prompt_code),
                      (unsigned)pkt.audio_prompt_code,
                      (unsigned)pkt.session_elapsed_sec);
    }
    simLastLoggedCue = pkt.audio_prompt_code;

    if (simPracticeDurationSec > 0 &&
        simTracker.getReading().elapsed_seconds >= simPracticeDurationSec) {
        endSimSession(now, "duration reached");
    }
}

// ---------------------------------------------------------------------------
// Setup / loop
// ---------------------------------------------------------------------------

void setup() {
    Serial.begin(115200);
    Serial.println("\n=========================================");
    Serial.println("     CPReady SIMULATION Firmware         ");
    Serial.println("=========================================");

    simPrefs.begin(SimConfig::NVS_NAMESPACE, false);

    const uint8_t savedProfile = simPrefs.getUChar(
        "profile", (uint8_t)CPReadyConfig::KinematicProfile::MANIKIN_STANDARD);

    // As in main.cpp: K values saved under the old depth model are discarded once.
    if (simPrefs.getUChar("depth_model", 0) != CPReadyConfig::DEPTH_MODEL_VERSION) {
        simPrefs.remove("depth_k");
        simPrefs.remove("k_manikin");
        simPrefs.remove("k_bench");
        simPrefs.putUChar("depth_model", CPReadyConfig::DEPTH_MODEL_VERSION);
        Serial.println("[NVS] Depth model changed: saved K values reset.");
    }
    float savedKManikin = simPrefs.getFloat("k_manikin", 0.0f);
    float savedKBench = simPrefs.getFloat("k_bench", 0.0f);
    if (savedKManikin >= CPReadyConfig::DEPTH_K_MIN && savedKManikin <= CPReadyConfig::DEPTH_K_MAX) {
        simTracker.setManikinDepthK(savedKManikin);
    }
    if (savedKBench >= CPReadyConfig::DEPTH_K_MIN && savedKBench <= CPReadyConfig::DEPTH_K_MAX) {
        simTracker.setBenchDepthK(savedKBench);
    }
    simTracker.setProfile((CPReadyConfig::KinematicProfile)savedProfile);
    if (simPrefs.isKey("trig_g")) simTracker.setMinStartThresholdG(simPrefs.getFloat("trig_g", CPReadyConfig::MIN_START_THRESHOLD_G));
    if (simPrefs.isKey("arm_frac")) simTracker.setRecoilArmFraction(simPrefs.getFloat("arm_frac", CPReadyConfig::RECOIL_ARM_FRACTION));
    if (simPrefs.isKey("min_d_cm")) simTracker.setMinStrokeDepthCm(simPrefs.getFloat("min_d_cm", CPReadyConfig::MIN_STROKE_DEPTH_CM));
    simUseDualMpu = simPrefs.getBool("dual_mpu", CPReadyConfig::DEFAULT_USE_DUAL_MPU);

    Serial.printf("[NVS] Profile %s | Depth K %.2f\n",
                  profileName(simTracker.getProfile()),
                  simTracker.getDepthK());

    simBle.begin(CPReadyConfig::BLE_DEVICE_NAME);
    simTelemetry.begin(&simBle);
    Serial.printf("[OK] BLE GATT server advertising as '%s'.\n", CPReadyConfig::BLE_DEVICE_NAME);
    Serial.println("[SIM] No sensors required.");
    Serial.println("[SIM] Console: SIM:STATUS | SIM:CALIB | SIM:START | SIM:STOP | "
                   "SIM:CUE:<1-6> | SIM:CALIB:FAIL | SIM:CALIB:OK | "
                   "SIM:TEST:DEPTH | SIM:TEST:RATE | SIM:TEST:RECOIL | "
                   "SIM:TEST:CCF | SIM:TEST:ALL | SIM:TEST:INVALID | SIM:TEST:STOP");
}

void loop() {
    const uint32_t now = millis();
    const uint32_t nowMicros = micros();

    pollSerial();

    // A dropped link aborts an in-flight session, as in the sensor build.
    if (simBle.checkAndClearDisconnectionEvent()) {
        simTelemetry.setEnabled(false);
        simPracticeDurationSec = CPReadyConfig::DEFAULT_PRACTICE_DURATION_SEC;
        if (simKTrialOverride) simRestoreSavedK();
        if (simState == DeviceState::CALIBRATING ||
            simState == DeviceState::ACTIVE_SESSION ||
            simState == DeviceState::SESSION_PAUSED ||
            simState == DeviceState::CALIBRATED_READY) {
            Serial.println("[BLE WARN] Disconnected during a session; aborting.");
            simTracker.reset();
            simState = DeviceState::STANDBY;
        }
    }

    while (simBle.hasPendingCommand()) {
        String cmd = simBle.consumeCommand();
        if (cmd.length() > 0) {
            handleBleCommand(cmd);
        }
    }

    if (simState == DeviceState::CALIBRATING) {
        updateCalibration(now, nowMicros);
    }
    else if (simState == DeviceState::ACTIVE_SESSION) {
        updateActiveSession(now, nowMicros);
    }
    else {
        delay(4);
    }
    delay(1);
}

#endif // CPREADY_SIMULATION
