Marni3/CPReady/(commit log)

2026-10-01 feat(firmware): finalize session protocol, audio guidance engine, and 11-byte BLE telemetry
    - Implement 11-byte packed little-endian BLE packet format with packet_type and audio_prompt_code
    - Integrate mobile phone audio coaching engine with 3.5s persistence window and 5.0s speech cooldown
    - Handle BLE disconnection with immediate session abort, buzzer silencing, and re-advertising
    - Implement pre-session calibration status signaling (PKT_TYPE_CALIB_PROGRESS and PKT_TYPE_CALIB_SUCCESS)
    - Add session-wide metrics finalization on STOP and summary retransmission via GET_RESULTS
    - Expose all audio coaching and sensitivity parameters in CPReadyConfig.h
    - Update software developer integration guid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
    [CPReady_Electronics.kicad_pcb, CPReady_Electronics.kicad_sch, MPL3115A2.f3d, PAJ7620.f3d, adxl345.f3d, audio_3.5mm_trrs.f3d, bmp180.f3d, module_si7021.f3d]
2026-10-03 fix(firmware): resolve 6 defects identified in architectural audit
    Fixes applied across CompressionTracker, SensorManager, and main loop
    following a full line-by-line audit of the CPReady firmware. All changes
    are additive safety guardrails or one-line corrections; no existing logic
    paths were restructured. Build verified clean (pio run, exit 0).
    --- CompressionTracker.h ---
    Stroke state machine watchdog (2000 ms timeout)
    The COMPRESSING -> RECOILING transition requires netAccel to cross
    below 0.0g, and RECOILING -> WAITING_FOR_DOWNSLICK requires it to
    cross back above -0.05g. A trainee resting or hesitating mid-stroke
    can hold the signal in a region where neither crossing ever occ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
    [CPReady_Program.ino, CompressionTracker.h, SensorManager.h, main.cpp]
2026-10-03 fix: compiler errors due to config file
    [CPReadyConfig.h, CPReady_Test_Bench.ino]
2026-10-10 feat: added explicit calibration BLE flow, command gating, and improved calibration configuration
2026-10-12 fix(kinematics): invert differential acceleration so downward compression is positive
    With MPU-6050 sensors mounted component-side up (+Z pointing toward the ceiling), downward chest compression accelerates in the -Z direction, causing (az - g_offset) to drop negative. Inverting rawNet ensures downward downstrokes produce positive acceleration matching the +0.45g trigger threshold in CompressionTracker.
2026-10-20 feat(firmware): add single-MPU operating mode and I2C bus recovery routine
    - Add USE_DUAL_MPU configuration toggle in CPReadyConfig.h
    - Guard base MPU initialization, sampling, and calibration in SensorManager.h
    - Implement 9-clock cycle I2C recovery routine to prevent i2cWriteReadNonStop lockups
    - Update startup logging in main.cpp and CPReady_Program.ino for Single- vs Dual-MPU mode
2026-10-20 feat(firmware): migrate to Adafruit MPU6050, add I2C bus scanner, and step clock to 100kHz
2026-10-24 docs: add hardware testing, calibration, and parameter tuning guide (PDF)
2026-10-24 feat(sensor): harden MPU detection with multi-address scanning, retry pings, WHO_AM_I diagnostics, and bus settling delays
2026-10-24 feat(sensor): add boot-time diagnostic multiplexer channel I2C scanner
2026-10-24 feat(firmware): integrate client kinematic hardening, NVS persistence, and clone MPU support
    - Vendor Adafruit_MPU6050 with WHO_AM_I support for clone/MPU6500 ICs (0x70/0x72)
    - Upgrade BLE telemetry packet to 12 bytes with quality_flags bitmask
    - Add audio prompt code 7 (PROMPT_STEADY_RHYTHM) and 4-sample cadence jitter tracking
    - Implement post-pause cadence fallback period anchoring to prevent false 10 cm ceiling spikes
    - Introduce runtime KinematicProfile switching (MANIKIN_STANDARD vs BENCH_TEST)
    - Add flash non-volatile storage (NVS via Preferences) for depth_k and active profile
    - Expand BLE command dispatcher with SET_K, SET_PROFILE, CALIBRATE_TARGET, RESET_CONFIG, GET_CONFIG
    - Update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
2026-10-24 docs: add recent features and mobile UI flow guide for Flutter developers (cadence coaching removed)
2026-10-25 Fix: Flutter Calibration
2026-10-25 fix(app): add sequential command queue with 150ms pacing and decoupled multi-step calibration UI
2026-10-25 docs: update calibration guides, developer protocol specs, and regenerate PDF
2026-10-26 firmware: add calibration error reason codes and state guards
2026-10-26 app: add BLE queue write timeout and reason-aware calibration errors
2026-10-26 docs: document calibration reason codes, depth smoothing, and BLE hardening
2026-10-27 fix(firmware): reliable BLE reconnect, stroke detection and sensor faults
    - BLE: restart advertising on every disconnect; count dropped commands;
    stamp each notification with a 16-bit sequence number.
    - Stroke detector: onset-based lockout, armed recoil exit, adaptive start
    threshold, live CCF, rate averages without first/post-pause strokes,
    pause/resume time compensation, one cue per prompt.
    - Recoil is reported as estimated (no force sensor); no leaning cue.
    - Sensors: fixed-rate sampling, I2C failure and stuck-value detection,
    re-init from FAULT_ERROR, MPU-6500 accel low-pass, direct 0x68/0x69 wiring.
    - Commands follow a state table; per-profile K with one-time migration.
    - Protoc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
2026-10-27 fix(app): protocol v2, packet-loss tracking and reliable live session
    - Decode 16-byte v2 packets (uint16 count, sequence) and keep 11/12-byte
    support; count lost packets per session (history schema v4).
    - BLE layer: subscribe before telemetry starts, async sendCommand,
    cancellable awaitPacketWhere.
    - Live screen: play a cue only when it changes, start watchdog ignores
    calibration packets, sensor fault ends the session without saving,
    recoil shown as estimated.
    - Grading: recoil compliance >= 90 %, graded CCF.
    - Wording fixes (per-profile K, guide without lay pulse check), brand
    colours, iOS Bluetooth usage string.
    - Tests for all of the above; cue gate clock injectable in widget t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
2026-10-27 docs: system audit, improvement plan and replay evidence
    - CPREADY_SYSTEM_AUDIT_AND_IMPROVEMENT_PLAN.md: findings, plan, and the
    record of changes and verification in this branch (section 9).
    - audit_evidence/tracker_replay: offline replay of CompressionTracker and
    the harmonic depth prototype, with captured results.
2026-10-27 docs: lab mode architecture proposal (for review)
    Separate lab firmware and app builds that stream raw 100 Hz data from both
    accelerometers and an optional force sensor, run a guided protocol of
    labelled bouts, record everything per session, and feed a PC analysis
    tool with pre-agreed decision rules for depth, detection, leaning and BLE.
    Not implemented yet.
2026-10-27 feat(firmware): integrate depth per stroke, tilt projection, median rate
    Depth is now the chest displacement integrated over each stroke cycle
    (DepthEstimator.h) instead of K * a_pp * T^2, which depended on stroke
    shape (a 5.5 cm push read 1.85-4.60 cm). On synthetic motion the median
    error is now within 0.2 cm for every shape, rate and depth.
    - Normal strokes: closed-cycle integration between stroke ends, mean
    acceleration and velocity removed. First strokes: integrated from rest,
    reported as unknown if the chest was not still.
    - K is kept as a correction factor (depth x K / profile default); saved K
    values from the old model are discarded once (NVS depth_model key).
    - Samples are pr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
2026-10-27 docs: add project README (aims, system, algorithms, references)
    Research-style overview for the repository front page: background and
    aims (research questions), hardware, session flow, signal processing and
    algorithms with equations (vertical projection, differential signal,
    filtering, stroke detection, per-stroke depth integration, rate, CCF,
    recoil estimate, coaching), BLE protocol, the app, software verification,
    repository layout, build steps, and references with verified DOIs.
2026-10-27 docs(readme): fix math rendering on GitHub; drop unconfirmed team names
    - GitHub's math renderer rejects \operatorname; use \mathrm for clamp and
    median.
    - The research-team names came from the proposal's author list and are not
    confirmed as current; the section now names only the school.
2026-10-30 fix(sensor): multiplexer downstream bus recovery, calibration fault reset, and 3MB flash expansion
    - Implement recoverDownstreamBus() to unhang stuck I2C slaves across PCA9548A multiplexer channels
    - Clear consecutiveReadFailures, identicalSampleCount, and sensorFault on resetCalibration()
    - Bypass frozen-sensor detection during motionless stationary baseline calibration
    - Increase SENSOR_FAULT_CONSECUTIVE_FAILS to 15 (150ms) and SENSOR_STUCK_SAMPLE_LIMIT to 250 (2.5s)
    - Configure huge_app.csv partition table and 115200 upload_speed in platformio.ini to expand flash to 3MB (reducing flash usage from 89.5% to 37.6%)
2026-10-30 fix(build): universal BLE string extraction for Arduino-ESP32 v2/v3, clean format warnings, and pin platform toolchain
2026-10-31 Update CPR sensor calibration and compression tracking
2026-10-31 firmware: dt-aware double integration, pause depth recovery, calibration reset, and dynamic I2C speed switching
2026-10-31 app: add I2C bus speed selector with reset warning dialog and auto-reset K on 15s calibration
2026-11-01 firmware: set empirical default manikin K=48.2, tune damped recoil detection, add runtime sensitivity & calibration bounds
2026-11-01 app: add detection sensitivity tuning panel, map ERR_CALIB_OUT_OF_RANGE, harden calibration & settings state
2026-11-01 Changes: telemetry -> supabase backend to monitor the data directly from the device
2026-11-04 feat(mvp): default to 1-MPU mode (K=11.20), add runtime MPU toggle, and fix telemetry race & summary clamping
2026-11-04 feat(kinematics): organize ground-truth trials, cap pre-onset dwell window, and tune HIGH preset recoil arm
2026-11-06 feat: implement Kinematic Model v6, match 10th GT session, and update error bounds
2026-11-07 feat(app,firmware): add 4-stage R3+filtfilt retroactive refinement and app-side dynamic voice coaching
    - Extend BLE Byte 11 quality_flags (bits 4..7) with per-stroke segmentation diagnostics (sub-300ms bounce, 66-sample window clamp, hesitation onset, envelope unmasked)
    - Implement 4-stage hybrid SessionRefinementEngine (self-calibrated zero-phase filtfilt on unsteady strokes, Case A split-stroke merge, Case B carryover rebalance, 100 Hz gap stroke recovery, local steady-median Winsorization) lowering 10-session Laerdal GT Depth MAE to 1.21 mm and Stroke Count MAE to 0.50
    - Implement LiveDepthStabilizer (3-stroke rolling median while unsteady) and LiveCoachingController v1 in Flutter with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
2026-11-07 docs: add student-friendly algorithm, code flow, and research defense guide (MD + PDF)
2026-11-08 Fix: Cadence gate on flutter won't allow audio to play on the actual device
2026-11-13 Fixed calibration and updated simulation env
